jacky4566/JacksNixies/PCBV2/PCBV2T.png

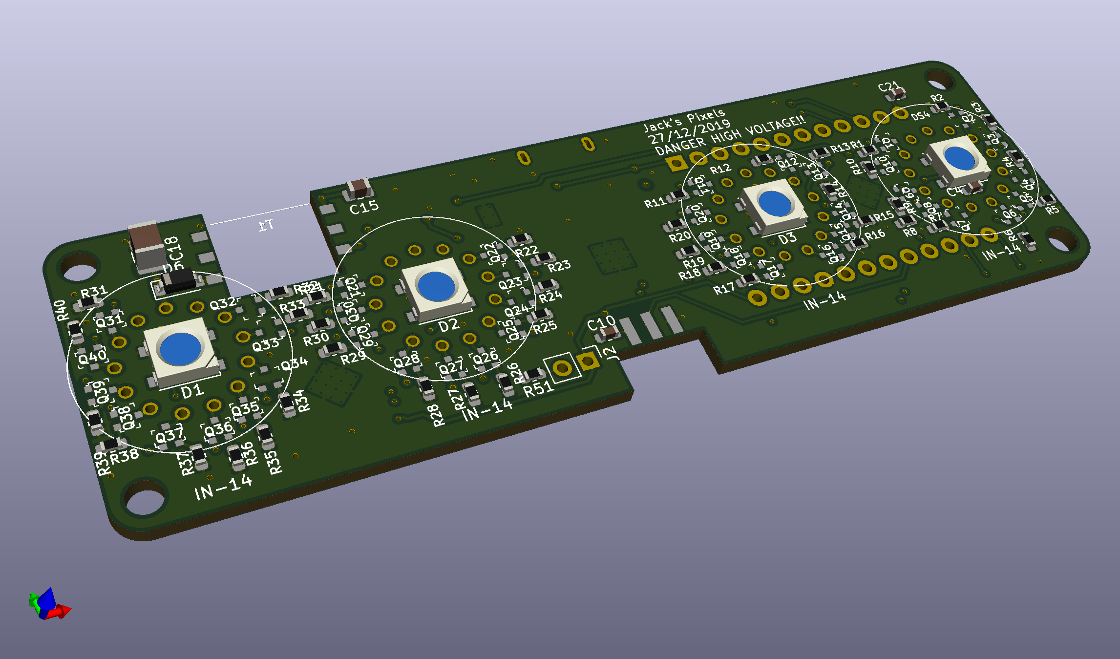
PCBV2/PCBV2T.png
