jacky4566/JacksNixies/PCBV2/PCBV2B.png

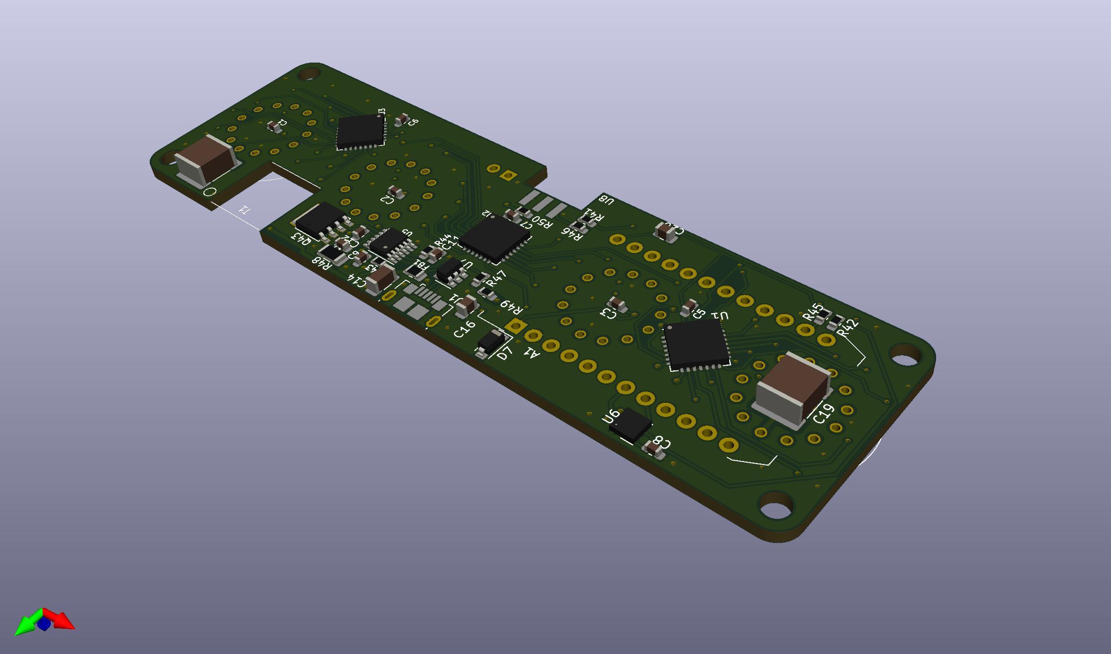
PCBV2/PCBV2B.png
