jacky4566/JacksNixies/Research/0x7d_nixietubeclock/README.md

# NixieTubeClock

Project files related to the Nixie Tube Clock project.

### Driver PCB
https://git.0x7d.com/Kevin/NixieTubeClock/raw/master/Nixie_Top_Board/PCB_Schematic.png











### Controller PCB
https://git.0x7d.com/Kevin/NixieTubeClock/raw/master/Nixie_Bottom_Board/PCB_Schematic.png

https://git.0x7d.com/Kevin/NixieTubeClock/raw/master/Nixie_Bottom_Board/PCB_Schematic2.png

https://git.0x7d.com/Kevin/NixieTubeClock/raw/master/Nixie_Bottom_Board/PCB_Full_NoSS.png







https://git.0x7d.com/Kevin/NixieTubeClock/raw/master/Nixie_Bottom_Board/PCB_Bottom.png
