jacky4566/JacksNixies/Research/0x7d_nixietubeclock/Misc Files/IN-24.jpg

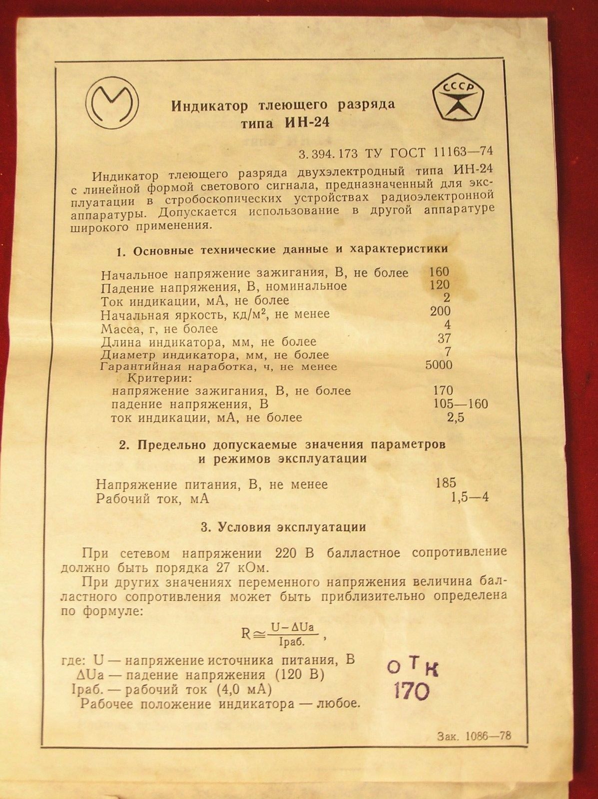
Research/0x7d_nixietubeclock/Misc Files/IN-24.jpg
