jacky4566/JacksNixies/Research/0x7d_nixietubeclock/Misc Files/TX4B-1.gif

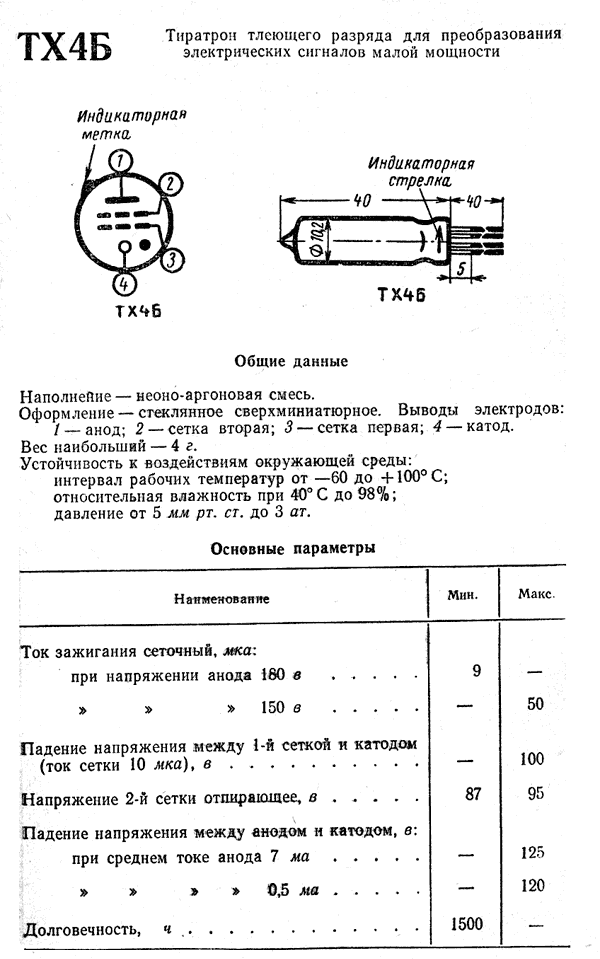
Research/0x7d_nixietubeclock/Misc Files/TX4B-1.gif
