jacky4566/JacksNixies/Research/0x7d_nixietubeclock/Misc Files/TX5B-2.jpg

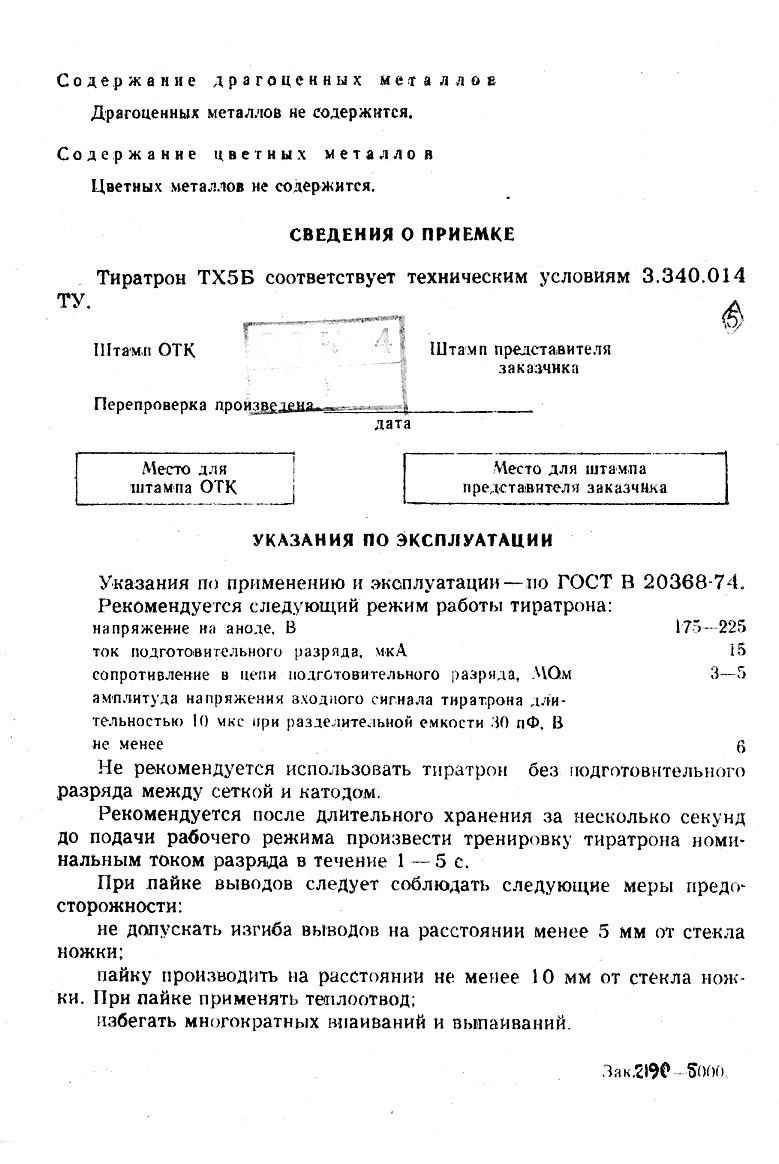
Research/0x7d_nixietubeclock/Misc Files/TX5B-2.jpg
