jacky4566/JacksNixies/Research/0x7d_nixietubeclock/Nixie_Bottom_Board/PCB_In2.png

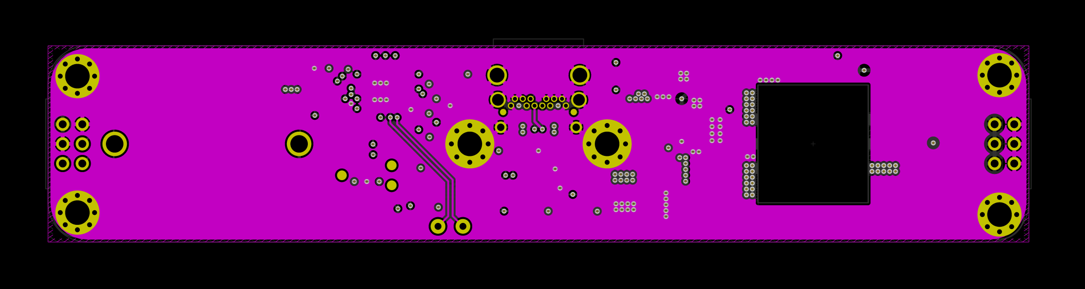
Research/0x7d_nixietubeclock/Nixie_Bottom_Board/PCB_In2.png
