jacky4566/JacksNixies/Research/0x7d_nixietubeclock/Nixie_Top_Board/PCB_Bottom.png

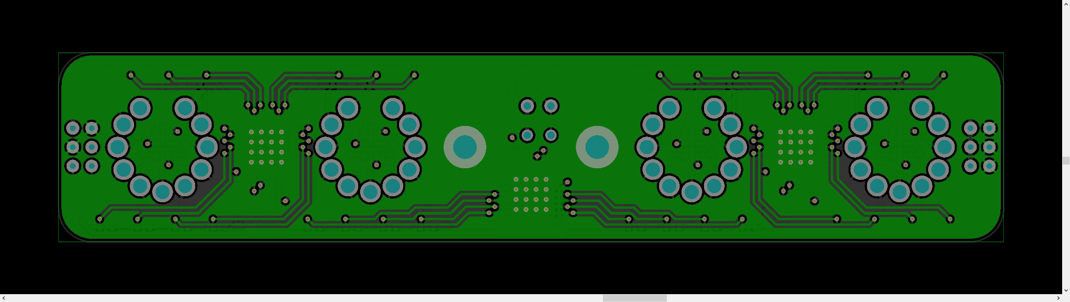
Research/0x7d_nixietubeclock/Nixie_Top_Board/PCB_Bottom.png
