jacky4566/JacksNixies/PCBV2/PCBV1_bom_.xlsx

Component | Description | Part | References | Value | Footprint | Quantity Per PCB | Digikey Part Num
1 | PHOTON WITH HEADERS | PHOTONH | A1 | PHOTONH | Particle_Photon | 1 | 1878-1005-ND
2 | Unpolarized capacitor, small symbol | C_Small | C1 C2 C3 C4 C5 C6 C7 C8 C10 C12 C13 C21 | 0.1uF | C_0603_1608Metric | 12 | 1276-1000-1-ND
3 | Unpolarized capacitor, small symbol | C_Small | C14 | 100uF | C_1206_3216Metric | 1 | 1276-1782-1-ND
4 | Unpolarized capacitor, small symbol | C_Small | C15 C16 C20 | 10uF | C_0805_2012Metric | 2 | 1276-2893-1-ND
5 | Unpolarized capacitor, small symbol | C_Small | C11 | 150nF | C_0603_1608Metric | 1 | 1276-1972-1-ND
6 | Unpolarized capacitor, small symbol | C_Small | C17 C18 C19 | 2.2uF | C_1210_3225Metric | 3 | 587-3380-1-ND
9 | Unpolarized capacitor, small symbol | C_Small | C9 | 560pF | C_0603_1608Metric | 1 | 490-1468-1-ND
10 | Bidirectional transient-voltage-suppression diode | D_TVS | D5 | 5.6V | D_SMA | 1 | SMAJ5.0ALFTR-ND
11 | Schottky diode | D_Schottky | D7, D6 | D_Schottky | D_SOD-123 | 2 | UF1GLWHRVGCT-ND
13 | 5050 RGBW LED 4-Pin with integrated IC | IN-PI55QATPRPGPBPW | D1 D2 D3 D4 | IN-PI55QATPRPGPBPW | LED_Inolux_IN-PI554FCH_PLCC4_5.0x5.0mm_P3.2mm | 4 | 1830-1210-2-ND
14 |  | NIXIE_IN14 | DS1 DS2 DS3 DS4 | NIXIE_IN14 | Nixie_IN_14 | 4
15 | Ferrite bead, small symbol | Ferrite_Bead_Small | FB1 | Ferrite_Bead_Small | R_0805_2012Metric | 1 | 732-1620-1-ND
16 | Generic connector, single row, 01x02, script generated (kicad-library-utils/schlib/autogen/connector/) | Conn_01x02_Female | J2 | Conn_01x02_Female | PinHeader_1x02_P2.54mm_Vertical | 1 | 475-1077-ND
17 | USB Micro Type B connector | USB_B_Micro | J1 | USB_B_Micro | USB_Micro-B_GCT_USB3076-30-A | 1 | 2073-USB3076-30-ACT-ND
18 | 100A, 60V Vds, N-Channel MOSFET, 5.2mOhm Ron, LFPAK56 | PSMN5R2-60YL | Q43 | PSMN5R2-60YL | LFPAK56 | 1 | 1727-2595-1-ND
19 | NPN transistor, base/emitter/collector | Q_NPN_BEC | Q1 Q2 Q3 Q4 Q5 Q6 Q7 Q8 Q9 Q10 Q11 Q12 Q13 Q14 Q15 Q16 Q17 Q18 Q19 Q20 Q21 Q22 Q23 Q24 Q25 Q26 Q27 Q28 Q29 Q30 Q31 Q32 Q33 Q34 Q35 Q36 Q37 Q38 Q39 Q40 | Q_NPN_BEC | SOT-323 | 40 | MSD42WT1GOSCT-ND
20 | Resistor, small symbol | R_Small | R49 | 1.6M | R_0603_1608Metric | 1 | P1.60MHCT-ND
21 | Resistor, small symbol | R_Small | R48 | 10m | R_1206_3216Metric | 1 | ERJ-8CWFR010V
22 | Resistor, small symbol | R_Small | R47 | 13k | R_0603_1608Metric | 1 | P13.0KHCT-ND
23 | Resistor, small symbol | R_Small | R41 R50 | 1M | R_0603_1608Metric | 2 | P1.00MHCT-ND
24 | Resistor, small symbol | R_Small | R1 R2 R3 R4 R5 R6 R7 R8 R9 R10 R11 R12 R13 R14 R15 R16 R17 R18 R19 R20 R21 R22 R23 R24 R25 R26 R27 R28 R29 R30 R31 R32 R33 R34 R35 R36 R37 R38 R39 R40 | 1k | R_0603_1608Metric | 40 | P1.00KHCT-ND
25 | Resistor, small symbol | R_Small | R43 | 300k | R_0603_1608Metric | 1 | P300KHCT-ND
26 | Resistor, small symbol | R_Small | R42 R45 R51 | 4.7k | R_0603_1608Metric | 3 | P4.70KHCT-ND
27 | Resistor, small symbol | R_Small | R44 R46 | 86.6K | R_0603_1608Metric | 2 | P86.6KHCT-ND
28 |  | 750312367 | T1 | 750312367 | 750312367 | 1 | 1297-1017-1-ND
29 |  | AM612-MargoGeneral | U8 | AM612 | AM612_Horz | 1
30 | It is a digital 4 in 1 sensor with gas, humidity, pressure and temperature measurements, LGA-8 | BME680 | U6 | BME680 | Bosch_LGA-8_3x3mm_P0.8mm_ClockwisePinNumbering | 1 | 828-1077-1-ND
31 |  | LT3759 | U5 | LT3759 | MSOP-12-1EP_3x4mm_P0.65mm_EP1.65x2.85mm_ThermalVias | 1 | LT3759EMSE#TRPBFCT-ND
32 | 16-channel 12-bit PWM Fm+ I2C-bus LED controller RGBA QFN | PCA9685BS | U1 U2 U3 | PCA9685BS | QFN-28-1EP_6x6mm_P0.65mm_EP4.25x4.25mm_ThermalVias | 3 | 568-5305-1-ND
33 | Single-Bit Dual-Supply Bus Transceiver With Configurable Voltage Translation and 3-State Outputs, SOT-563 | SN74LVC1T45DRL | U4 | SN74LVC1T45DRL | SOT-563 | 1 | 296-20629-1-ND
34 | USB Dedicated Charging Port Controller | TPS2514 | U7 | TPS2514 | SOT-23-6 | 1 | 296-40725-1-ND
