jacky4566/JacksNixies/PCBV1/Main/Assem16.SLDASM

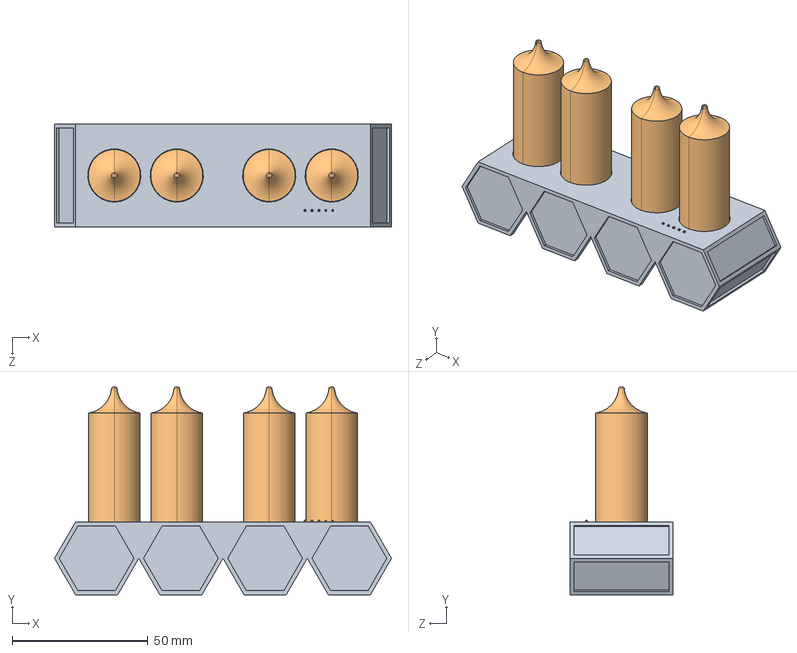
[picture p22: CAD file, 2020-06-26]
PCBV1/Main/Assem16.SLDASM
124.0 x 76.4 x 38.0 mm
Case1
PCBV1
