jacky4566/JacksNixies/Housing 1.SLDPRT

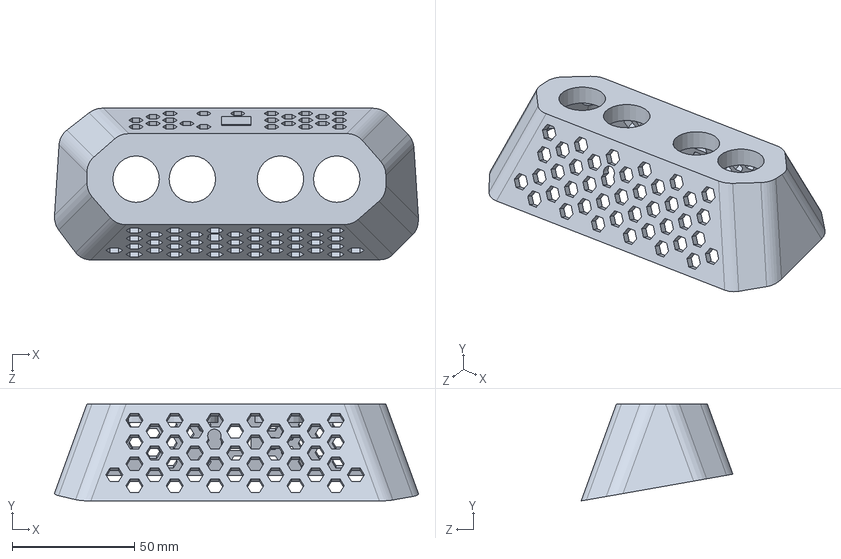
[picture p23: CAD file, 2020-06-26]
Housing 1.SLDPRT
148.8 x 39.6 x 62.0 mm
