jacky4566/JacksNixies/PCBV1/Main/PCBV1.SLDPRT

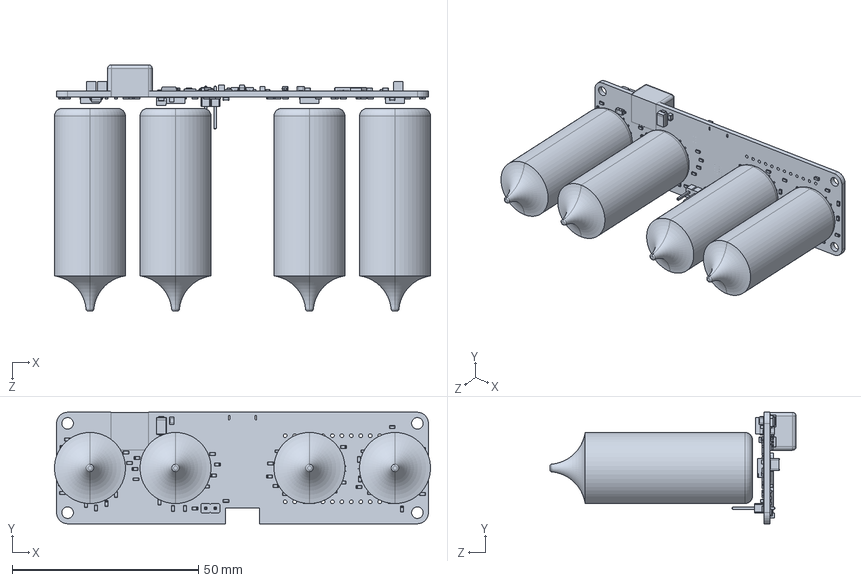
[picture p24: CAD file, 2020-06-26]
PCBV1/Main/PCBV1.SLDPRT
101.1 x 30.0 x 66.2 mm
