jacky4566/JacksNixies/Lid.SLDPRT

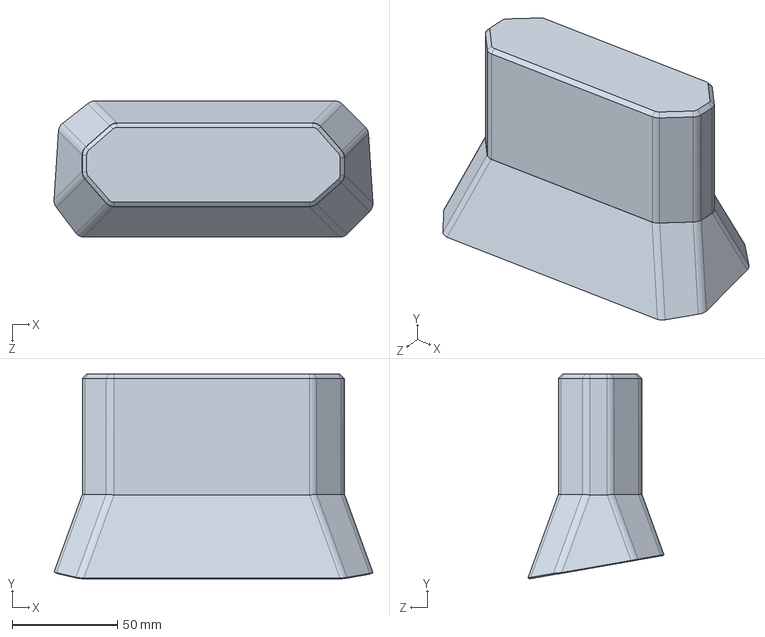
[picture p25: CAD file, 2020-06-26]
Lid.SLDPRT
151.9 x 97.5 x 64.9 mm
