jacky4566/JacksNixies/PCBV1/Main/Case1.SLDPRT

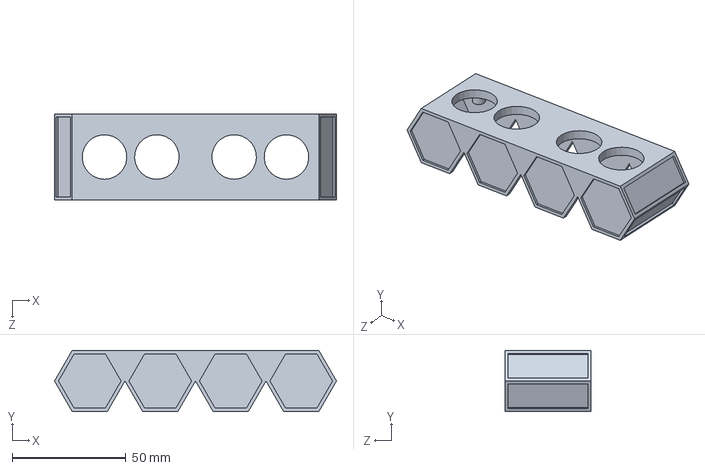
[picture p26: CAD file, 2020-06-26]
PCBV1/Main/Case1.SLDPRT
124.0 x 26.8 x 38.0 mm
