jacky4566/JacksNixies/Alignment Tool.SLDPRT

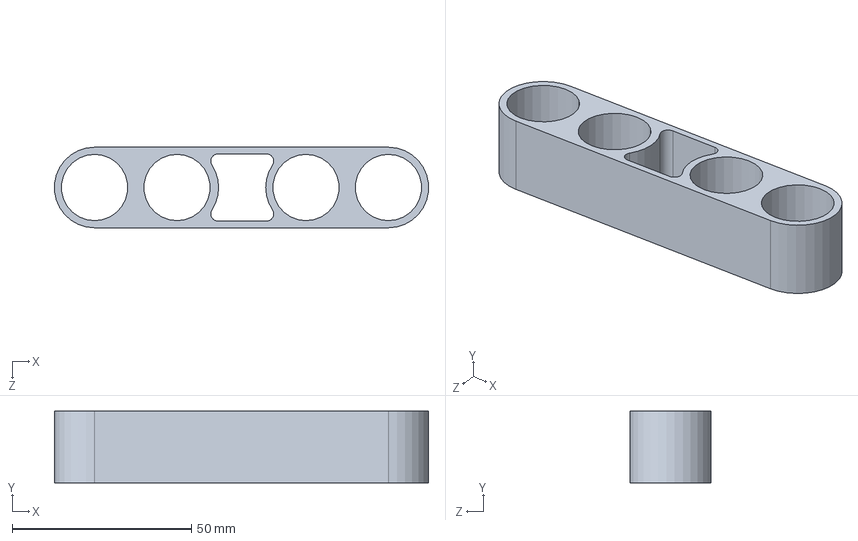
[picture p27: CAD file, 2020-06-26]
Alignment Tool.SLDPRT
104.4 x 20.0 x 22.5 mm
