jacky4566/JacksNixies/(list of files, cad)

Other CAD files:
Alignment Tool.STL
Housing 1.STL
Lid.STL
PCBV1/Main/Case1.STL
