jacky4566/JacksNixies/Research/0x7d_nixietubeclock/Nixie_PSU_Breakout/Efficiency Measurement.xlsx

Sheet: 8200HV
Input Voltage | Input Current | Output Voltage | Output Current | Input Power | Output Power | % Efficiency
3 | 0.079 | 171.4 | 0.001 | 0.237 | 0.171 | 0.723
3 | 0.145 | 170.6 | 0.002 | 0.435 | 0.341 | 0.784
3 | 0.202 | 170.7 | 0.003 | 0.606 | 0.512 | 0.845
3 | 0.270 | 170.4 | 0.004 | 0.810 | 0.682 | 0.841
3 | 0.337 | 170.3 | 0.005 | 1.011 | 0.852 | 0.842
3 | 0.405 | 170.2 | 0.006 | 1.215 | 1.021 | 0.840
3 | 0.471 | 170.0 | 0.007 | 1.413 | 1.190 | 0.842
3 | 0.537 | 169.9 | 0.008 | 1.611 | 1.359 | 0.844
3 | 0.605 | 169.9 | 0.009 | 1.815 | 1.529 | 0.842
3 | 0.676 | 169.8 | 0.010 | 2.028 | 1.698 | 0.837
3 | 0.747 | 169.6 | 0.011 | 2.241 | 1.866 | 0.832
3 | 0.829 | 169.5 | 0.012 | 2.487 | 2.034 | 0.818
3 | 0.897 | 169.5 | 0.013 | 2.691 | 2.204 | 0.819
3 | 0.968 | 169.4 | 0.014 | 2.904 | 2.372 | 0.817
5 | 0.045 | 171.6 | 0.001 | 0.225 | 0.172 | 0.763
5 | 0.088 | 171.5 | 0.002 | 0.440 | 0.343 | 0.780
5 | 0.122 | 171.1 | 0.003 | 0.610 | 0.513 | 0.841
5 | 0.160 | 170.9 | 0.004 | 0.800 | 0.684 | 0.854
5 | 0.201 | 170.8 | 0.005 | 1.005 | 0.854 | 0.850
5 | 0.240 | 170.7 | 0.006 | 1.200 | 1.024 | 0.854
5 | 0.276 | 170.7 | 0.007 | 1.380 | 1.195 | 0.866
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
