jacky4566/JacksNixies/PCBV2/PCBV2_Schematic.pdf

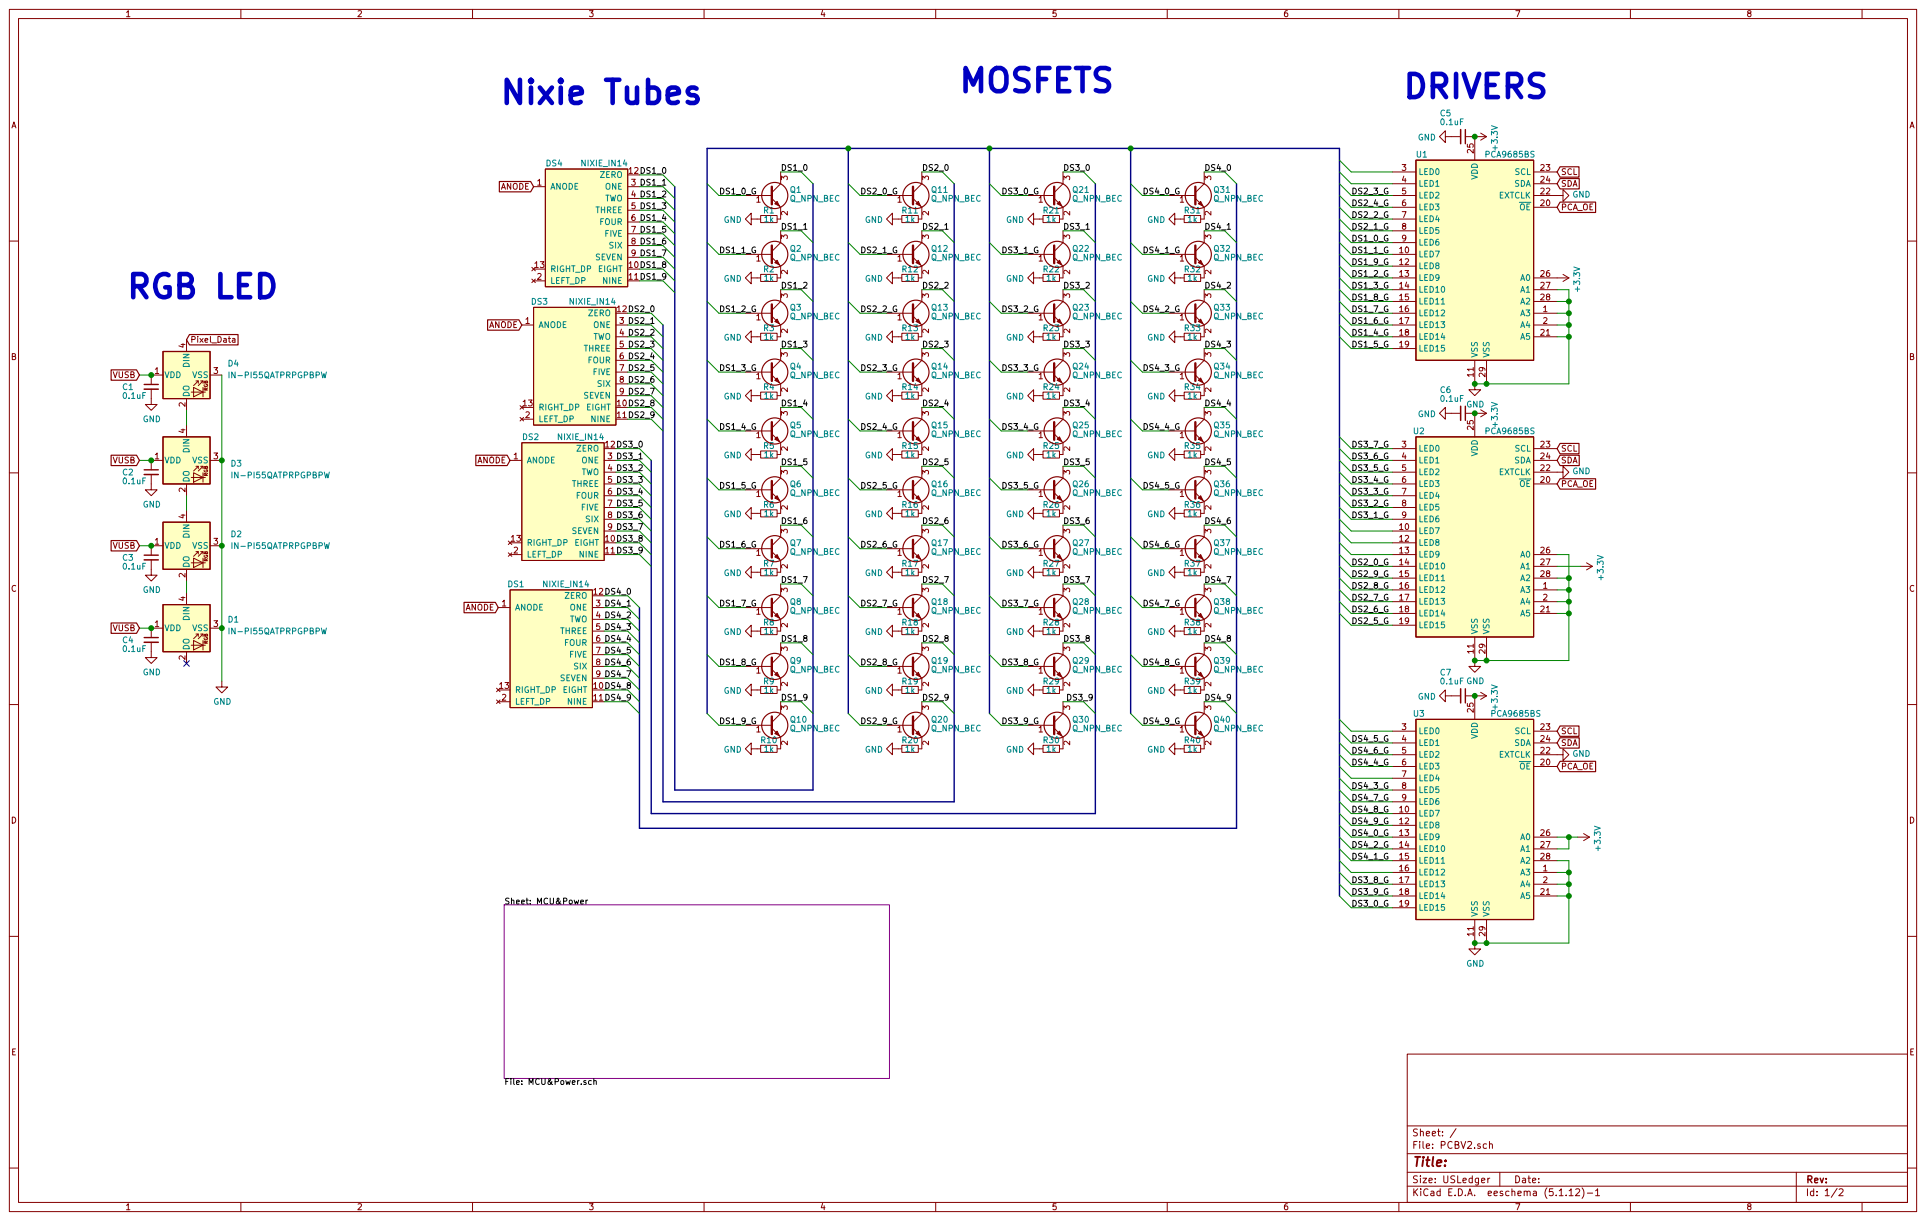
[picture p28: page 1]

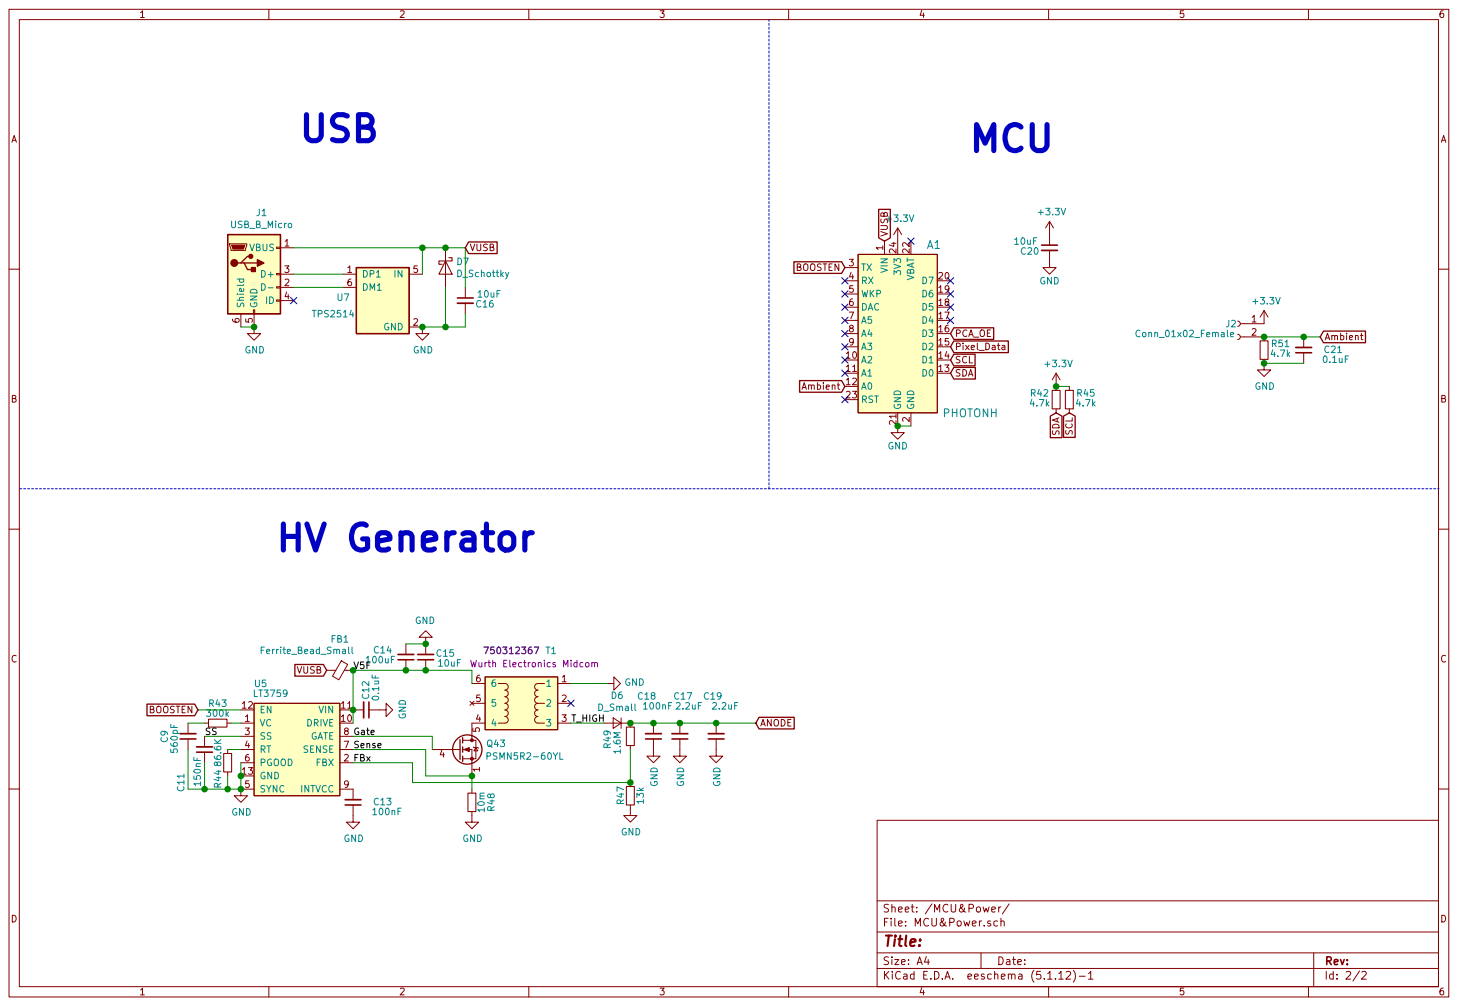
[picture p29: page 2]

2 TX 3 RX 4 WKP 5 DAC 6 A5 7 A4 8 A3 9 A2 10 D7 20 A1 11 GND 21 A0 12 VBAT 22 D0 13 RST 23 D1 14 3V3 24 D2 15 D3 16 D4 17 D5 18 D6 19 A1 PHOTONH
