jacky4566/JacksNixies/PCBV1/Main/Print Schematic.pdf

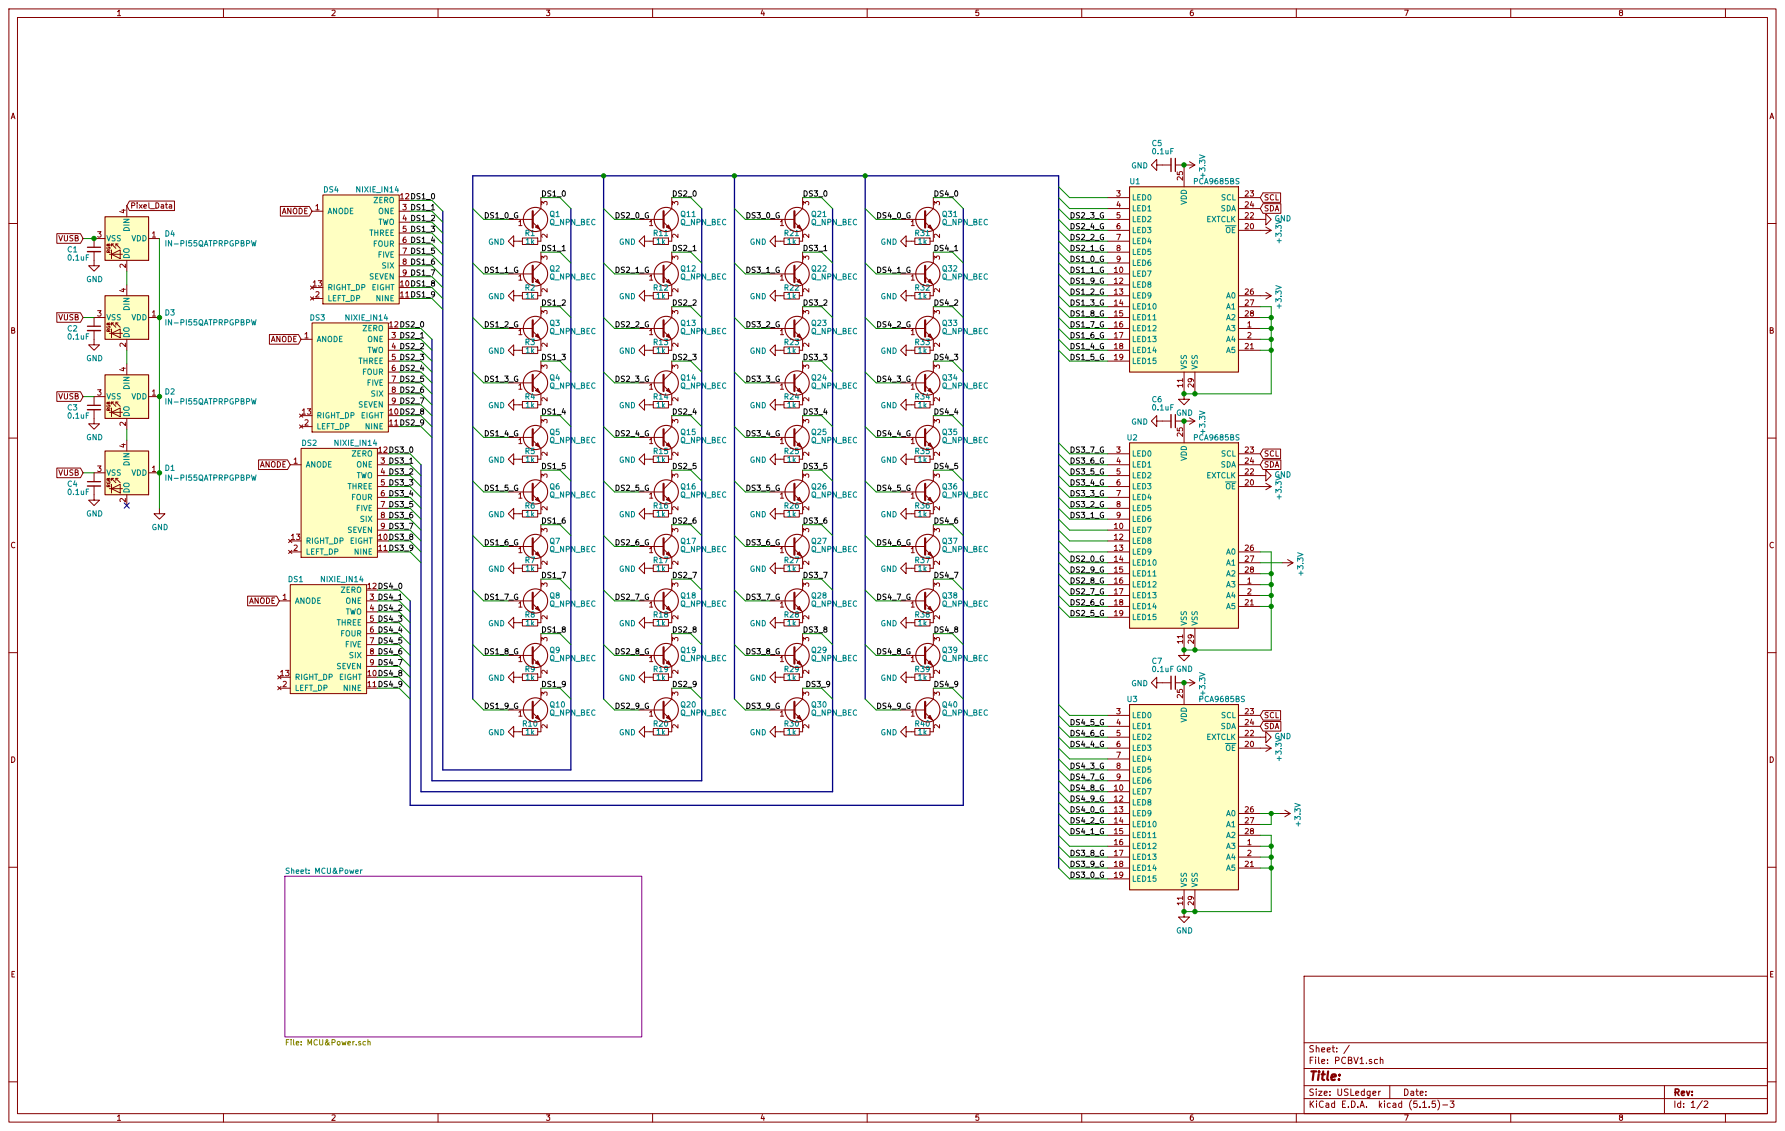
[picture p30: page 1]

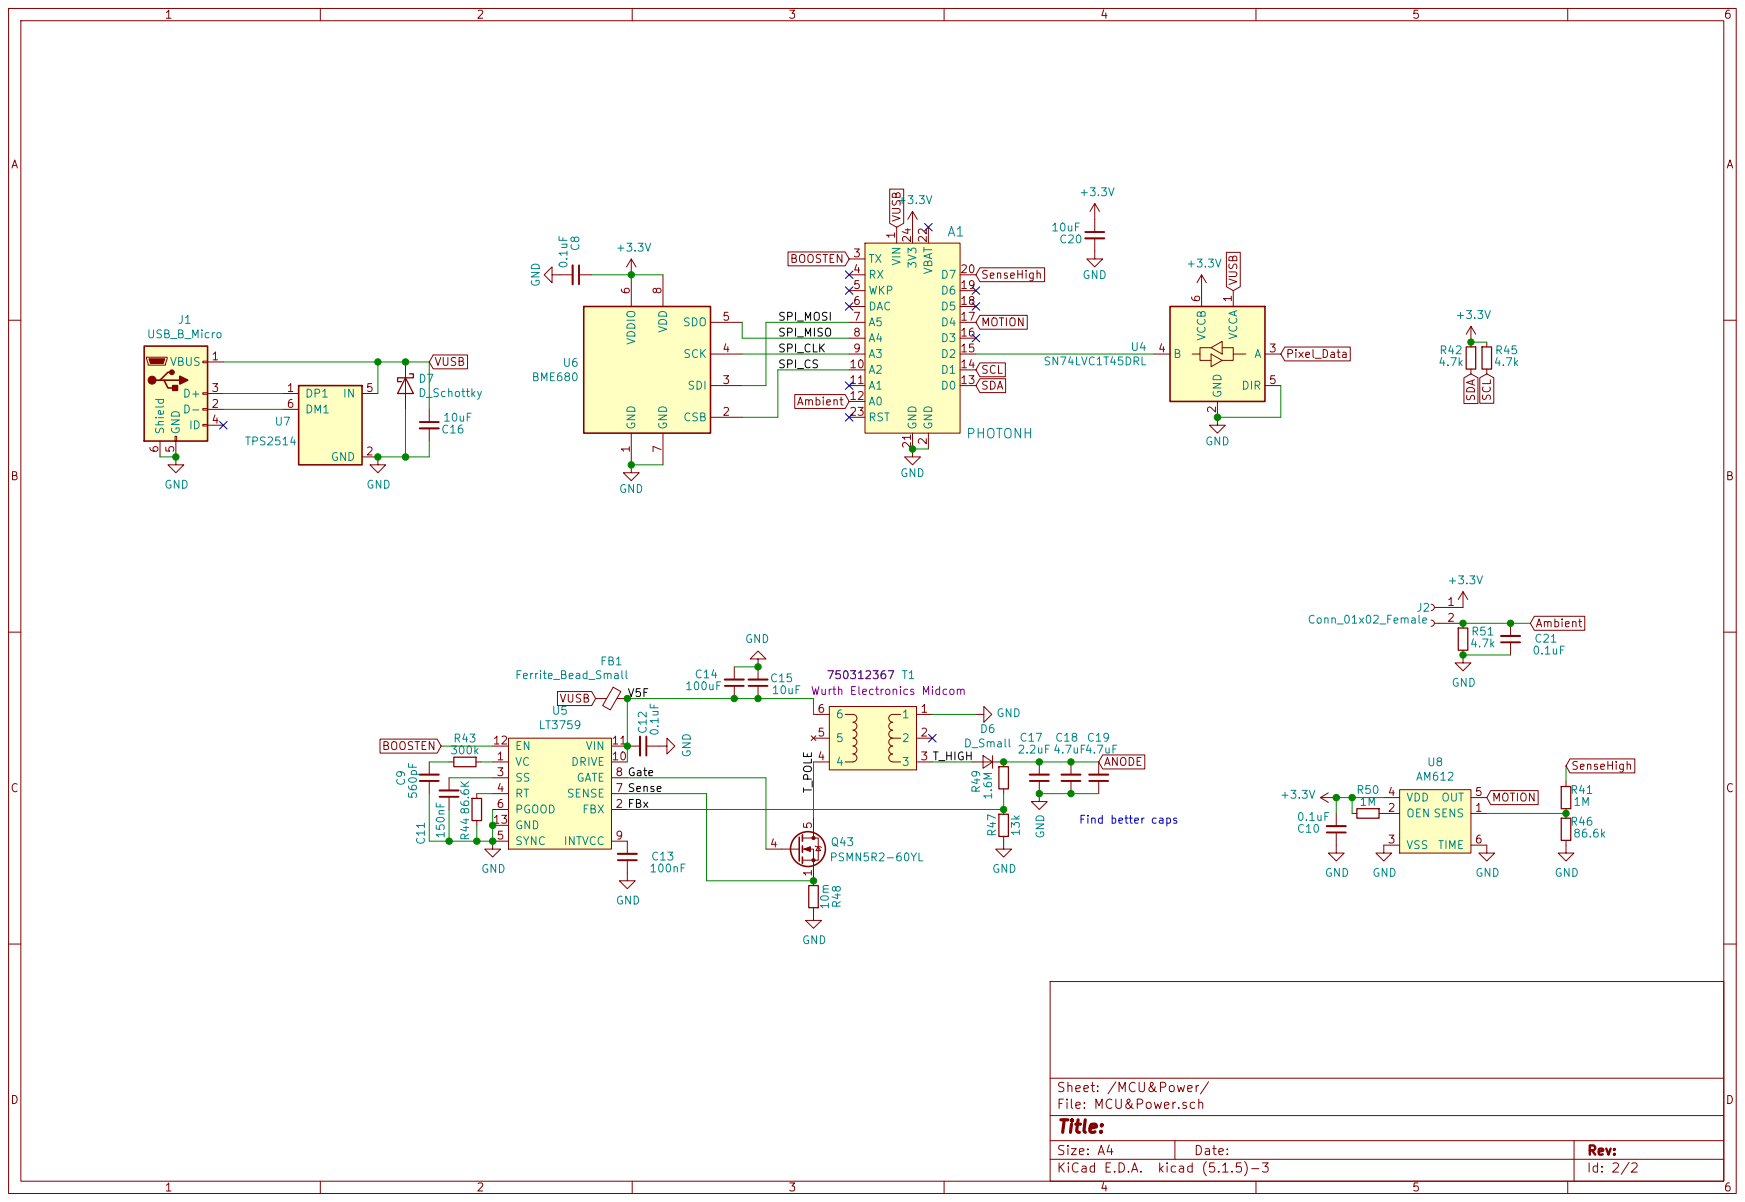
[picture p31: page 2]
