jacky4566/JacksNixies/Research/0x7d_nixietubeclock/Nixie_PSU_Breakout/LTspice/Schematic.asc

C1: cap; 1.2µ; V=200 Irms=4.41 Rser=0.0220943 Lser=0 mfg="KEMET" pn="C1825C125K2RAC" type="X7R"
C2: cap; 1µ; V=200 Irms=3.96 Rser=0.0234673 Lser=0 mfg="KEMET" pn="C1825C105K2RAC" type="X7R"
C3: cap; 0.1µ; V=25 Irms=2.1 Rser=0.0606238 Lser=0 mfg="KEMET" pn="C1210C104K3RAC" type="X7R"
C4: cap; 100µ; V=25 Irms=18.5 Rser=0.00262245 Lser=0
C5: cap; 150n; V=50 Irms=1.11 Rser=0.0283161 Lser=0
C6: cap; 500p; V=16 Irms=647m Rser=0.0322889 Lser=0
C7: cap; 4.7µ; V=50 Irms=0 Rser=0.004 Lser=0 mfg="TDK" pn="C575OX7RIH475M" type="X7R"
D1: diode; RFU02VS6S
I1: load2; PULSE(0 -0.002 16m)
R1: res; 10m; tol=1 pwr=0.1
R2: res; 86.6K; tol=1 pwr=0.1
R3: res; 300k; tol=1 pwr=0.1
R4: res; 1.6Meg; tol=1 pwr=0.1
R5: res; 13k; tol=1 pwr=0.1
U1: LT3759
U2: 750312367
U3: EPCGaN; EPC2016
V1: voltage; 3.7; Rser=20m
Named nets: VOUT, 0, VIN
.tran 0 40m 1m
