jacky4566/JacksNixies/Research/0x7d_nixietubeclock/Nixie_Top_Board/nixie_top_board.kicad_pcb

## KiCad design Research/0x7d_nixietubeclock/Nixie_Top_Board/nixie_top_board.kicad_pcb (2020-06-26)

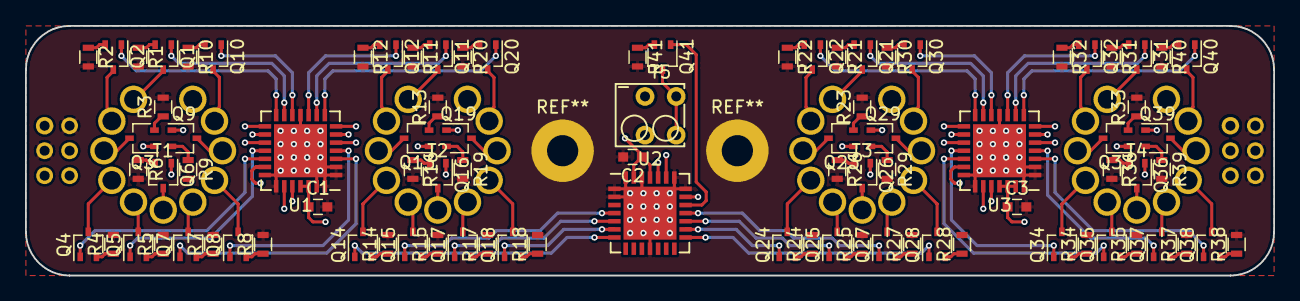
[picture p32: board nixie_top_board.kicad_pcb from above]

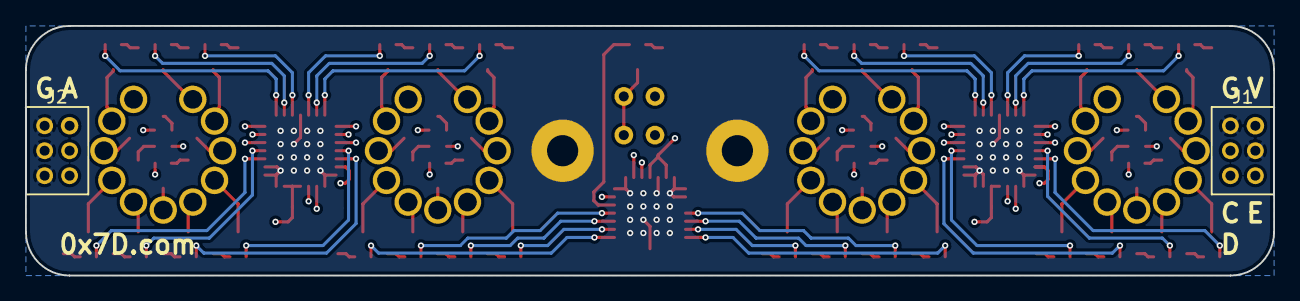
[picture p33: board nixie_top_board.kicad_pcb from below]

Board: 4 copper layers, 100.0 x 20.0 mm, 95 parts (2 on the bottom side), 129 nets.

Parts:
C1, C2, C3: Bypass; C_0603
J1, J2: Conn_02x03_Odd_Even; Pin_Header_Straight_2x03_Pitch2.00mm
Q1, Q2, Q3, Q4, Q5, Q6, Q7, Q8, Q9, Q10, Q11, Q12, Q13, Q14, Q15, Q16, Q17, Q18, Q19, Q20, Q21, Q22, Q23, Q24, Q25, Q26, Q27, Q28, Q29, Q30, Q31, Q32, Q33, Q34, Q35, Q36, Q37, Q38, Q39, Q40, Q41: Q_NPN_BEC; SOT-323_SC-70
R1, R2, R3, R4, R5, R6, R7, R8, R9, R10, R11, R12, R13, R14, R15, R16, R17, R18, R19, R20, R21, R22, R23, R24, R25, R26, R27, R28, R29, R30, R31, R32, R33, R34, R35, R36, R37, R38, R39, R40, R41: R; R_0603
T1, T2, T3, T4: IN-8
T5: IN-3; Phoenix_1770953
U1, U2, U3: PCA9685; QFN-28-1EP_6x6mm_Pitch0.65mm

Connections:
/ANODE: J2.1, J2.3, J2.5, T1.11, T2.11, T3.11, T4.11, T5.1
/GND: C1.2, C2.2, C3.2, J1.2, J1.3, J2.2, J2.4, J2.6, R1.2, R2.2, R3.2, R4.2, R5.2, R6.2, R7.2, R8.2, R9.2, R10.2, R11.2, R12.2, R13.2, R14.2, R15.2, R16.2, R17.2, R18.2, R19.2, R20.2, R21.2, R22.2, R23.2, R24.2, R25.2, R26.2, R27.2, R28.2, R29.2, R30.2, R31.2, R32.2, R33.2, R34.2, R35.2, R36.2, R37.2, R38.2, R39.2, R40.2, R41.2, U1.1, U1.2, U1.11, U1.21, U1.22, U1.27, U1.28, U1.29, U2.1, U2.2, U2.11, U2.21, U2.22, U2.26, U2.28, U2.29, U3.1, U3.2, U3.11, U3.21, U3.22, U3.28, U3.29
/SCL: J1.4, U1.23, U2.23, U3.23
/SDA: J1.6, U1.24, U2.24, U3.24
/T1_C_0: Q1.3, T1.1
/T1_C_1: Q2.3, T1.2
/T1_C_2: Q3.3, T1.3
/T1_C_3: Q4.3, T1.4
/T1_C_4: Q5.3, T1.5
/T1_C_5: Q6.3, T1.6
/T1_C_6: Q7.3, T1.7
/T1_C_7: Q8.3, T1.8
/T1_C_8: Q9.3, T1.9
/T1_C_9: Q10.3, T1.10
/T1_E_0: Q1.2, R1.1
/T1_E_1: Q2.2, R2.1
/T1_E_2: Q3.2, R3.1
/T1_E_3: Q4.2, R4.1
/T1_E_4: Q5.2, R5.1
/T1_E_5: Q6.2, R6.1
/T1_E_6: Q7.2, R7.1
/T1_E_7: Q8.2, R8.1
/T1_E_8: Q9.2, R9.1
/T1_E_9: Q10.2, R10.1
/T1_G_0: Q1.1, U1.13
/T1_G_1: Q2.1, U1.14
/T1_G_2: Q3.1, U1.16
/T1_G_3: Q4.1, U1.19
/T1_G_4: Q5.1, U1.18
/T1_G_5: Q6.1, U1.15
/T1_G_6: Q7.1, U1.3
/T1_G_7: Q8.1, U1.4
/T1_G_8: Q9.1, U1.17
/T1_G_9: Q10.1, U1.12
/T2_C_0: Q11.3, T2.1
/T2_C_1: Q12.3, T2.2
/T2_C_2: Q13.3, T2.3
/T2_C_3: Q14.3, T2.4
/T2_C_4: Q15.3, T2.5
/T2_C_5: Q16.3, T2.6
/T2_C_6: Q17.3, T2.7
/T2_C_7: Q18.3, T2.8
/T2_C_8: Q19.3, T2.9
/T2_C_9: Q20.3, T2.10
/T2_E_0: Q11.2, R11.1
/T2_E_1: Q12.2, R12.1
/T2_E_2: Q13.2, R13.1
/T2_E_3: Q14.2, R14.1
/T2_E_4: Q15.2, R15.1
/T2_E_5: Q16.2, R16.1
/T2_E_6: Q17.2, R17.1
/T2_E_7: Q18.2, R18.1
/T2_E_8: Q19.2, R19.1
/T2_E_9: Q20.2, R20.1
/T2_G_0: Q11.1, U1.9
/T2_G_1: Q12.1, U1.10
/T2_G_2: Q13.1, U1.5
/T2_G_3: Q14.1, U2.7
/T2_G_4: Q15.1, U2.4
/T2_G_5: Q16.1, U1.7
/T2_G_6: Q17.1, U2.5
/T2_G_7: Q18.1, U2.6
/T2_G_8: Q19.1, U1.6
/T2_G_9: Q20.1, U1.8
/T3_C_0: Q21.3, T3.1
/T3_C_1: Q22.3, T3.2
/T3_C_2: Q23.3, T3.3
/T3_C_3: Q24.3, T3.4
/T3_C_4: Q25.3, T3.5
/T3_C_5: Q26.3, T3.6
/T3_C_6: Q27.3, T3.7
/T3_C_7: Q28.3, T3.8
/T3_C_8: Q29.3, T3.9
/T3_C_9: Q30.3, T3.10
/T3_E_0: Q21.2, R21.1
/T3_E_1: Q22.2, R22.1
/T3_E_2: Q23.2, R23.1
/T3_E_3: Q24.2, R24.1
/T3_E_4: Q25.2, R25.1
/T3_E_5: Q26.2, R26.1
/T3_E_6: Q27.2, R27.1
/T3_E_7: Q28.2, R28.1
/T3_E_8: Q29.2, R29.1
/T3_E_9: Q30.2, R30.1
/T3_G_0: Q21.1, U3.13
/T3_G_1: Q22.1, U3.14
/T3_G_2: Q23.1, U3.16
/T3_G_3: Q24.1, U2.16
/T3_G_4: Q25.1, U2.17
/T3_G_5: Q26.1, U3.15
/T3_G_6: Q27.1, U2.18
/T3_G_7: Q28.1, U2.15
/T3_G_8: Q29.1, U3.17
/T3_G_9: Q30.1, U3.12
/T4_C_0: Q31.3, T4.1
/T4_C_1: Q32.3, T4.2
/T4_C_2: Q33.3, T4.3
/T4_C_3: Q34.3, T4.4
/T4_C_4: Q35.3, T4.5
/T4_C_5: Q36.3, T4.6
/T4_C_6: Q37.3, T4.7
/T4_C_7: Q38.3, T4.8
/T4_C_8: Q39.3, T4.9
/T4_C_9: Q40.3, T4.10
/T4_E_0: Q31.2, R31.1
/T4_E_1: Q32.2, R32.1
/T4_E_2: Q33.2, R33.1
/T4_E_3: Q34.2, R34.1
/T4_E_4: Q35.2, R35.1
/T4_E_5: Q36.2, R36.1
/T4_E_6: Q37.2, R37.1
/T4_E_7: Q38.2, R38.1
/T4_E_8: Q39.2, R39.1
/T4_E_9: Q40.2, R40.1
/T4_G_0: Q31.1, U3.9
/T4_G_1: Q32.1, U3.10
/T4_G_2: Q33.1, U3.5
/T4_G_3: Q34.1, U3.18
/T4_G_4: Q35.1, U3.19
/T4_G_5: Q36.1, U3.7
/T4_G_6: Q37.1, U3.4
/T4_G_7: Q38.1, U3.3
/T4_G_8: Q39.1, U3.6
/T4_G_9: Q40.1, U3.8
/VDD: C1.1, C2.1, C3.1, J1.1, U1.25, U1.26, U2.25, U2.27, U3.25, U3.26, U3.27
/nOE: J1.5, U1.20, U2.20, U3.20
unnamed: Q41.1, U2.19
unnamed: Q41.2, R41.1
unnamed: Q41.3, T5.2
