jacky4566/JacksNixies/Research/0x7d_nixietubeclock/Nixie_Bottom_Board/nixie_bottom_board.kicad_pcb

## KiCad design Research/0x7d_nixietubeclock/Nixie_Bottom_Board/nixie_bottom_board.kicad_pcb (2020-06-26)

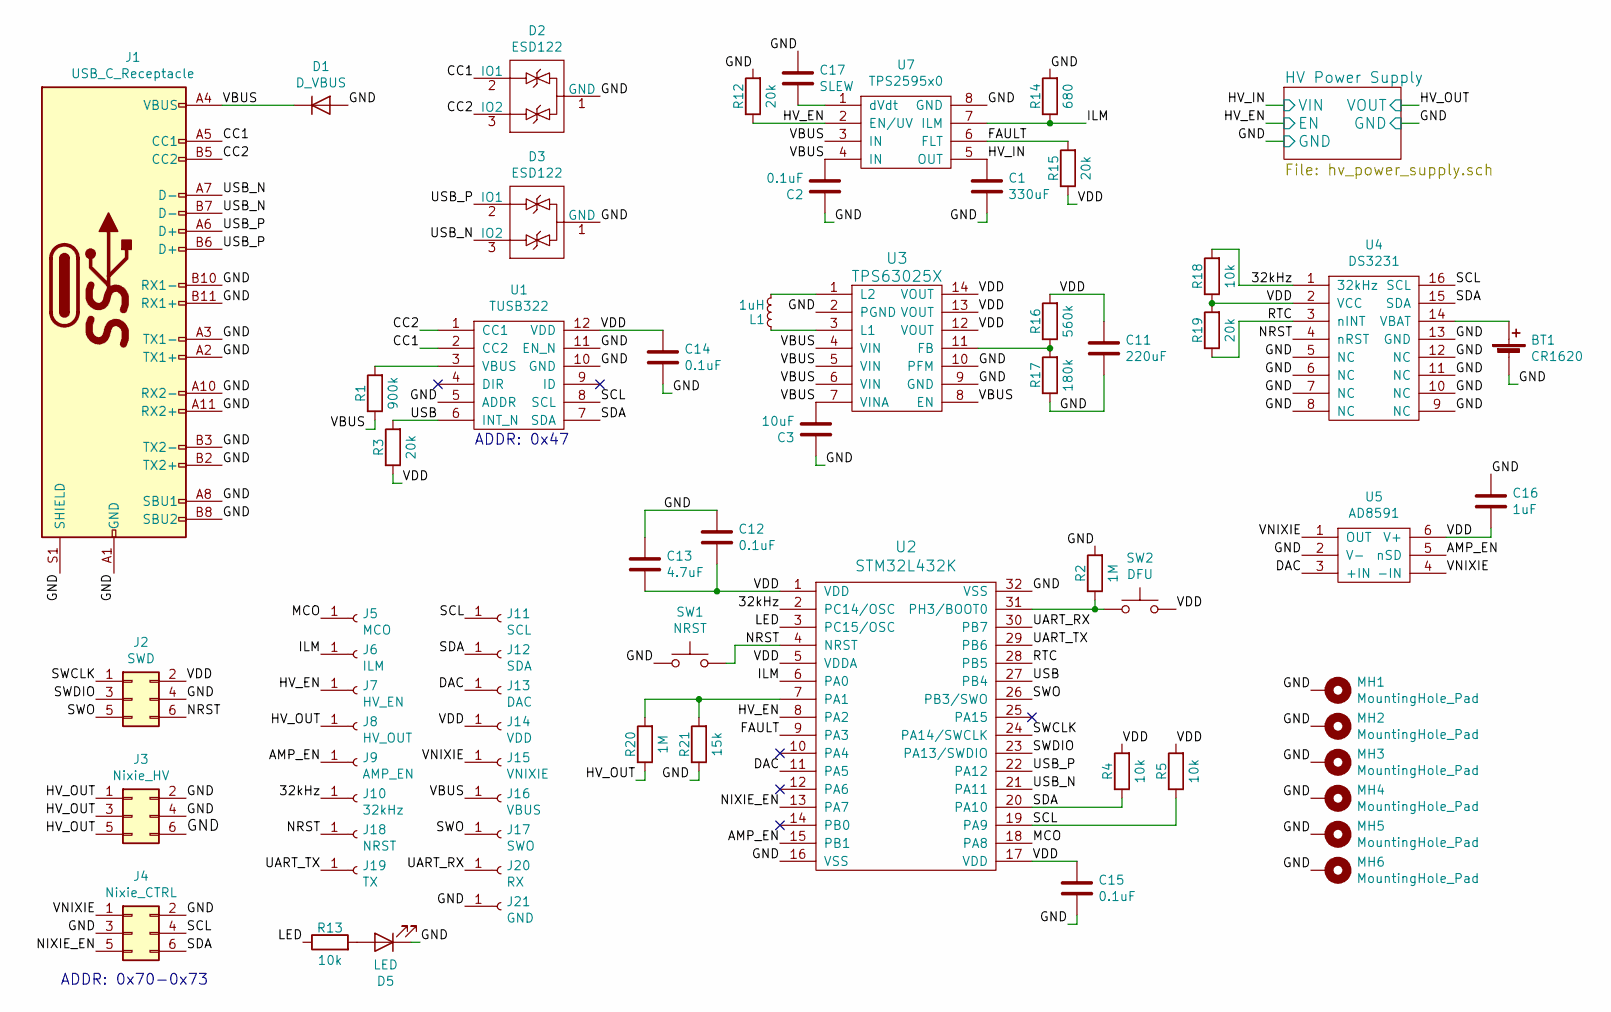
[picture p34: schematic nixie_bottom_board.sch, Bottom PCB]

Parts:
BT1: CR1620; CR1620_Holder_TH
C1: 330uF; CP_Tantalum_Case-X_EIA-7343-43_Reflow
C2, C12, C14, C15: 0.1uF; C_0603
C3: 10uF; C_0603
C11: 220uF; C_1210
C13: 4.7uF; C_0603
C16: 1uF; C_0603
C17: SLEW; C_0603
D1: D_VBUS; X1SON
D2, D3: ESD122; DMX0003A
D5: LED; LED_0603
J1: USB_C_Receptacle; USB_C_Receptacle_Circular_Holes
J2: SWD; TC2030-MCP-NL
J3: Nixie_HV; Pin_Header_Harwin_2x03_Pitch2.00mm
J4: Nixie_CTRL; Pin_Header_Harwin_2x03_Pitch2.00mm
J5: MCO; TestPoint_Pad_D1.5mm
J6: ILM; TestPoint_Pad_D1.5mm
J7: HV_EN; TestPoint_Pad_D1.5mm
J8: HV_OUT; TestPoint_Pad_D1.5mm
J9: AMP_EN; TestPoint_Pad_D1.5mm
J10: 32kHz; TestPoint_Pad_D1.5mm
J11: SCL; TestPoint_Pad_D1.5mm
J12: SDA; TestPoint_Pad_D1.5mm
J13: DAC; TestPoint_Pad_D1.5mm
J14: VDD; TestPoint_Pad_D1.5mm
J15: VNIXIE; TestPoint_Pad_D1.5mm
J16: VBUS; TestPoint_Pad_D1.5mm
J17: SWO; TestPoint_Pad_D1.5mm
J18: NRST; TestPoint_Pad_D1.5mm
J19: TX; TestPoint_THTPad_D1.5mm_Drill0.7mm
J20: RX; TestPoint_THTPad_D1.5mm_Drill0.7mm
J21: GND; TestPoint_Pad_D1.5mm
L1: 1uH; Inductor_4.1x4.1mm
MH1, MH2, MH3, MH4, MH5, MH6: MountingHole_Pad; MountingHole_2.5mm_Pad_Via
R1: 900k; R_0603
R2, R20: 1M; R_0603
R3, R12, R15, R19: 20k; R_0603
R4, R5, R13, R18: 10k; R_0603
R14: 680; R_0603
R16: 560k; R_0603
R17: 180k; R_0603
R21: 15k; R_0603
SW1: NRST; EVQP2
SW2: DFU; EVQP2
U1: TUSB322; X2QFN-12_1.6x1.6mm_Pitch0.4mm
U2: STM32L432K; QFN-32-1EP_5x5mm_Pitch0.5mm
U3: TPS63025X; VQFN-14_2.5x3mm_Pitch0.5mm
U4: DS3231; SOIC-16W_7.5x10.3mm_Pitch1.27mm
U5: AD8591; SOT-23-6
U7: TPS2595x0; WSON-8_1EP_2x2mm_Pitch0.5mm

Connections:
/32kHz: J10.1, R18.2, U2.2 (PC14/OSC), U4.1 (32kHz)
/AMP_EN: J9.1, U2.15 (PB1), U5.5 (nSD)
/CC1: D2.2 (IO1), J1.A5 (CC1), U1.2 (CC2)
/CC2: D2.3 (IO2), J1.B5 (CC2), U1.1 (CC1)
/DAC: J13.1, U2.11 (PA5), U5.3 (+IN)
/FAULT: R15.2, U2.9 (PA3), U7.6 (FLT)
/GND: BT1.2 (-), C1.1, C2.2, C3.2, C11.1, C12.2, C13.2, C14.1, C15.1, C16.2, C17.2, D1.2 (A), D2.1 (GND), D3.1 (GND), D5.1 (K), J1.A1 (GND), J1.A2 (TX1+), J1.A3 (TX1-), J1.A8 (SBU1), J1.A10 (RX2-), J1.A11 (RX2+), J1.A12 (GND), J1.B1 (GND), J1.B2 (TX2+), J1.B3 (TX2-), J1.B8 (SBU2), J1.B10 (RX1-), J1.B11 (RX1+), J1.B12 (GND), J1.S1 (SHIELD), J2.4, J3.2, J3.4, J3.6, J4.2, J4.3, J21.1, MH1.1, MH2.1, MH3.1, MH4.1, MH5.1, MH6.1, R2.2, R12.2, R14.2, R17.1, R21.1, SW1.1, U1.5 (ADDR), U1.10 (GND), U1.11 (EN_N), U2.16 (VSS), U2.32 (VSS), U2.33 (VSS), U3.2 (PGND), U3.9 (GND), U3.10 (PFM), U4.5 (NC), U4.6 (NC), U4.7 (NC), U4.8 (NC), U4.9 (NC), U4.10 (NC), U4.11 (NC), U4.12 (NC), U4.13 (GND), U5.2 (V-), U7.8 (GND), U7.9 (GND); also elsewhere on the board
/HV_EN: J7.1, R12.1, U2.8 (PA2), U7.2 (EN/UV); also elsewhere on the board
/HV_IN: C1.2, U7.5 (OUT); also elsewhere on the board
/HV_OUT: J3.1, J3.3, J3.5, J8.1, R20.1; also elsewhere on the board
/ILM: J6.1, R14.1, U2.6 (PA0), U7.7 (ILM)
/LED: R13.1, U2.3 (PC15/OSC)
/MCO: J5.1, U2.18 (PA8)
/NIXIE_EN: J4.5, U2.13 (PA7)
/NRST: J2.6, J18.1, SW1.2, U2.4 (NRST), U4.4 (nRST)
/RTC: R19.1, U2.28 (PB5), U4.3 (nINT)
/SCL: J4.4, J11.1, R5.1, U1.8 (SCL), U2.19 (PA9), U4.16 (SCL)
/SDA: J4.6, J12.1, R4.1, U1.7 (SDA), U2.20 (PA10), U4.15 (SDA)
/SWCLK: J2.1, U2.24 (PA14/SWCLK)
/SWDIO: J2.3, U2.23 (PA13/SWDIO)
/SWO: J2.5, J17.1, U2.26 (PB3/SWO)
/UART_RX: J20.1, U2.30 (PB7)
/UART_TX: J19.1, U2.29 (PB6)
/USB: R3.2, U1.6 (INT_N), U2.27 (PB4)
/USB_N: D3.3 (IO2), J1.A7 (D-), J1.B7 (D-), U2.21 (PA11)
/USB_P: D3.2 (IO1), J1.A6 (D+), J1.B6 (D+), U2.22 (PA12)
/VBUS: C2.1, C3.1, D1.1 (K), J1.A4 (VBUS), J1.A9 (VBUS), J1.B4 (VBUS), J1.B9 (VBUS), J16.1, R1.1, U3.4 (VIN), U3.5 (VIN), U3.6 (VIN), U3.7 (VINA), U3.8 (EN), U7.3 (IN), U7.4 (IN)
/VDD: C11.2, C12.1, C13.1, C14.2, C15.2, C16.1, J2.2, J14.1, R3.1, R4.2, R5.2, R15.1, R16.2, R18.1, R19.2, SW2.2, U1.12 (VDD), U2.1 (VDD), U2.5 (VDDA), U2.17 (VDD), U3.12 (VOUT), U3.13 (VOUT), U3.14 (VOUT), U4.2 (VCC), U5.6 (V+)
/VNIXIE: J4.1, J15.1, U5.1 (OUT), U5.4 (-IN)
unnamed: BT1.1 (+), U4.14 (VBAT)
unnamed: C17.1, U7.1 (dVdt)
unnamed: D5.2 (A), R13.2
unnamed: L1.1, U3.3 (L1)
unnamed: L1.2, U3.1 (L2)
unnamed: R1.2, U1.3 (VBUS)
unnamed: R2.1, SW2.1, U2.31 (PH3/BOOT0)
unnamed: R16.1, R17.2, U3.11 (FB)
unnamed: R20.2, R21.2, U2.7 (PA1)

Notes on the sheet:
ADDR: 0x47
ADDR: 0x70-0x73

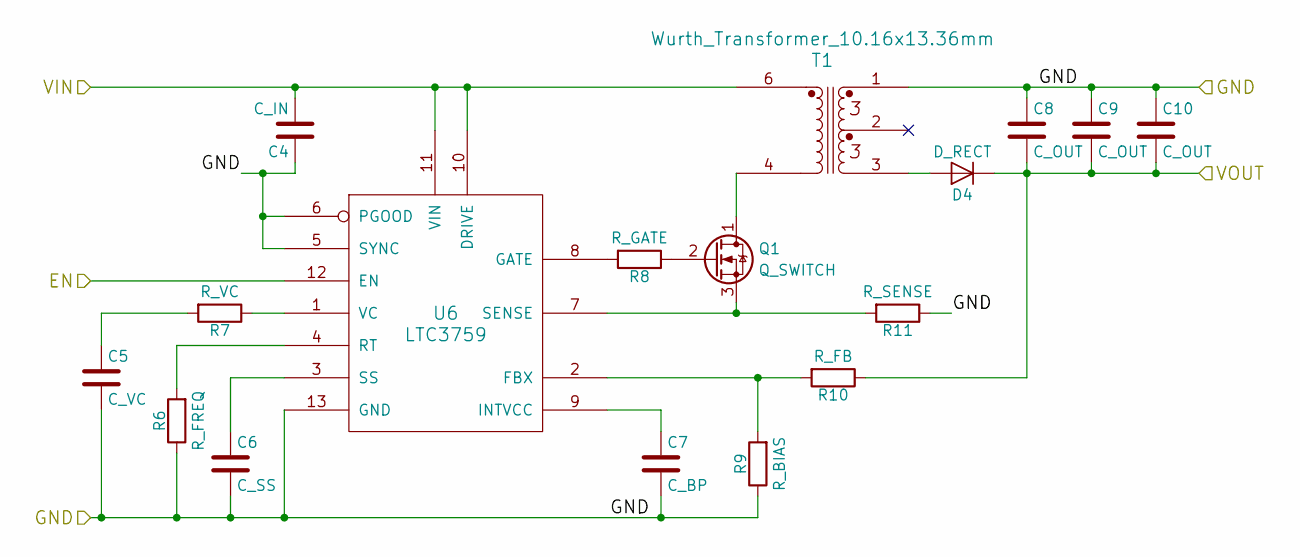
[picture p35: schematic hv_power_supply.sch, Bottom PCB]

Parts:
C4: C_IN; C_0805
C5: C_VC; C_0603
C6: C_SS; C_0603
C7: C_BP; C_0603
C8, C10: C_OUT; C_2220
C9: C_OUT; C_1812
D4: D_RECT; SOD-123W
Q1: Q_SWITCH; SOT-669_LFPAK
R6: R_FREQ; R_0603
R7: R_VC; R_0603
R8: R_GATE; R_0603
R9: R_BIAS; R_0603
R10: R_FB; R_0603
R11: R_SENSE; R_0805
T1: Wurth_Transformer_10.16x13.36mm; Wurth_WE-FB_10.18x13.36mm_Reverse
U6: LTC3759; MSOP-12-1EP_3x4mm_Pitch0.65mm

Connections:
/GND: C4.1, C5.2, C6.2, C7.2, C8.1, C9.1, C10.1, R6.1, R9.1, R11.1, T1.1, U6.5 (SYNC), U6.6 (PGOOD), U6.13 (GND); also elsewhere on the board
/HV_EN: U6.12 (EN); also elsewhere on the board
/HV_IN: C4.2, T1.6, U6.10 (DRIVE), U6.11 (VIN); also elsewhere on the board
/HV_OUT: C8.2, C9.2, C10.2, D4.1 (K), R10.1; also elsewhere on the board
unnamed: C5.1, R7.2
unnamed: C6.1, U6.3 (SS)
unnamed: C7.1, U6.9 (INTVCC)
unnamed: D4.2 (A), T1.3
unnamed: Q1.1 (D), T1.4
unnamed: Q1.2 (G), R8.1
unnamed: Q1.3 (S), R11.2, U6.7 (SENSE)
unnamed: R6.2, U6.4 (RT)
unnamed: R7.1, U6.1 (VC)
unnamed: R8.2, U6.8 (GATE)
unnamed: R9.2, R10.2, U6.2 (FBX)

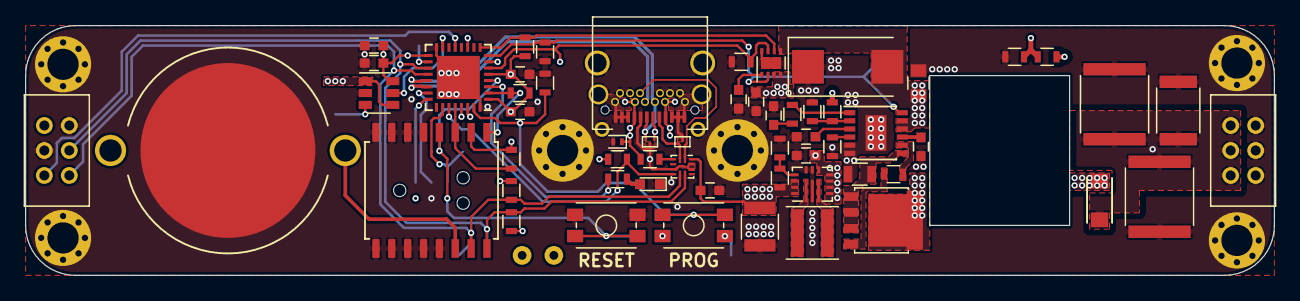
[picture p36: board nixie_bottom_board.kicad_pcb from above]

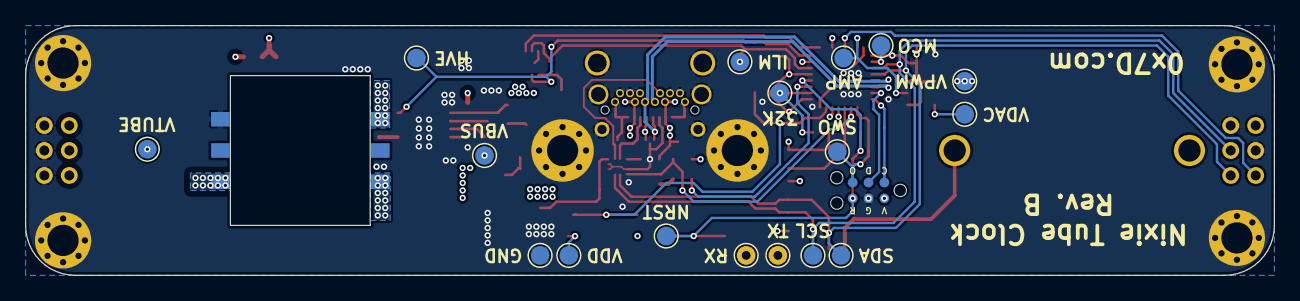
[picture p37: board nixie_bottom_board.kicad_pcb from below]

Board: 4 copper layers, 100.0 x 20.0 mm, 83 parts (18 on the bottom side), 49 nets.
