jacky4566/JacksNixies/Research/0x7d_nixietubeclock/Nixie_PSU_Breakout/nixie_psu_breakout.kicad_pcb

## KiCad design Research/0x7d_nixietubeclock/Nixie_PSU_Breakout/nixie_psu_breakout.kicad_pcb (2020-06-26)

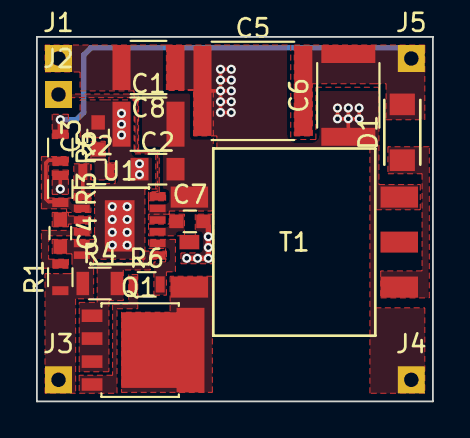
[picture p38: board nixie_psu_breakout.kicad_pcb from above]

Board: 2 copper layers, 22.0 x 20.2 mm, 23 parts (0 on the bottom side), 15 nets.

Parts:
C1, C8: C_IN; C_1210
C2: C_IN; C_0805
C3: C_VC; C_0603
C4: C_SS; C_0603
C5: C_OUT; C_2220
C6: C_OUT; C_1812
C7: C_BP; C_0603
D1: D_RECT; SOD-123W
J1: VIN; Measurement_Point_Square-TH_Small
J2: EN; Measurement_Point_Square-TH_Small
J3, J4: GND; Measurement_Point_Square-TH_Small
J5: VOUT; Measurement_Point_Square-TH_Small
Q1: Q_SWITCH; SOT-669_LFPAK
R1: R_FREQ; R_0603
R2: R_VC; R_0603
R3: R_BIAS; R_0603
R4: R_SENSE; R_0805
R5: R_FB; R_0603
R6: R_GATE; R_0603
T1: Wurth_Transformer_10.16x13.36mm; Wurth_WE-FB_10.18x13.36mm
U1: LTC3759; MSOP-12-1EP_3x4mm_Pitch0.65mm

Connections:
GNDREF: C1.1, C2.1, C3.2, C4.2, C5.1, C6.1, C7.2, C8.1, J3.1, J4.1, R1.1, R3.1, R4.1, T1.1, U1.5, U1.6, U1.13
unnamed: C1.2, C2.2, C8.2, J1.1, T1.6, U1.10, U1.11
unnamed: C3.1, R2.2
unnamed: C4.1, U1.3
unnamed: C5.2, C6.2, D1.1, J5.1, R5.1
unnamed: C7.1, U1.9
unnamed: D1.2, T1.3
unnamed: J2.1, U1.12
unnamed: Q1.1, T1.4
unnamed: Q1.2, R6.1
unnamed: Q1.3, R4.2, U1.7
unnamed: R1.2, U1.4
unnamed: R2.1, U1.1
unnamed: R3.2, R5.2, U1.2
unnamed: R6.2, U1.8
