jacky4566/JacksNixies/PCBV2/PCBV2.kicad_pcb

## KiCad design PCBV2/PCBV2.kicad_pcb (2020-06-26)

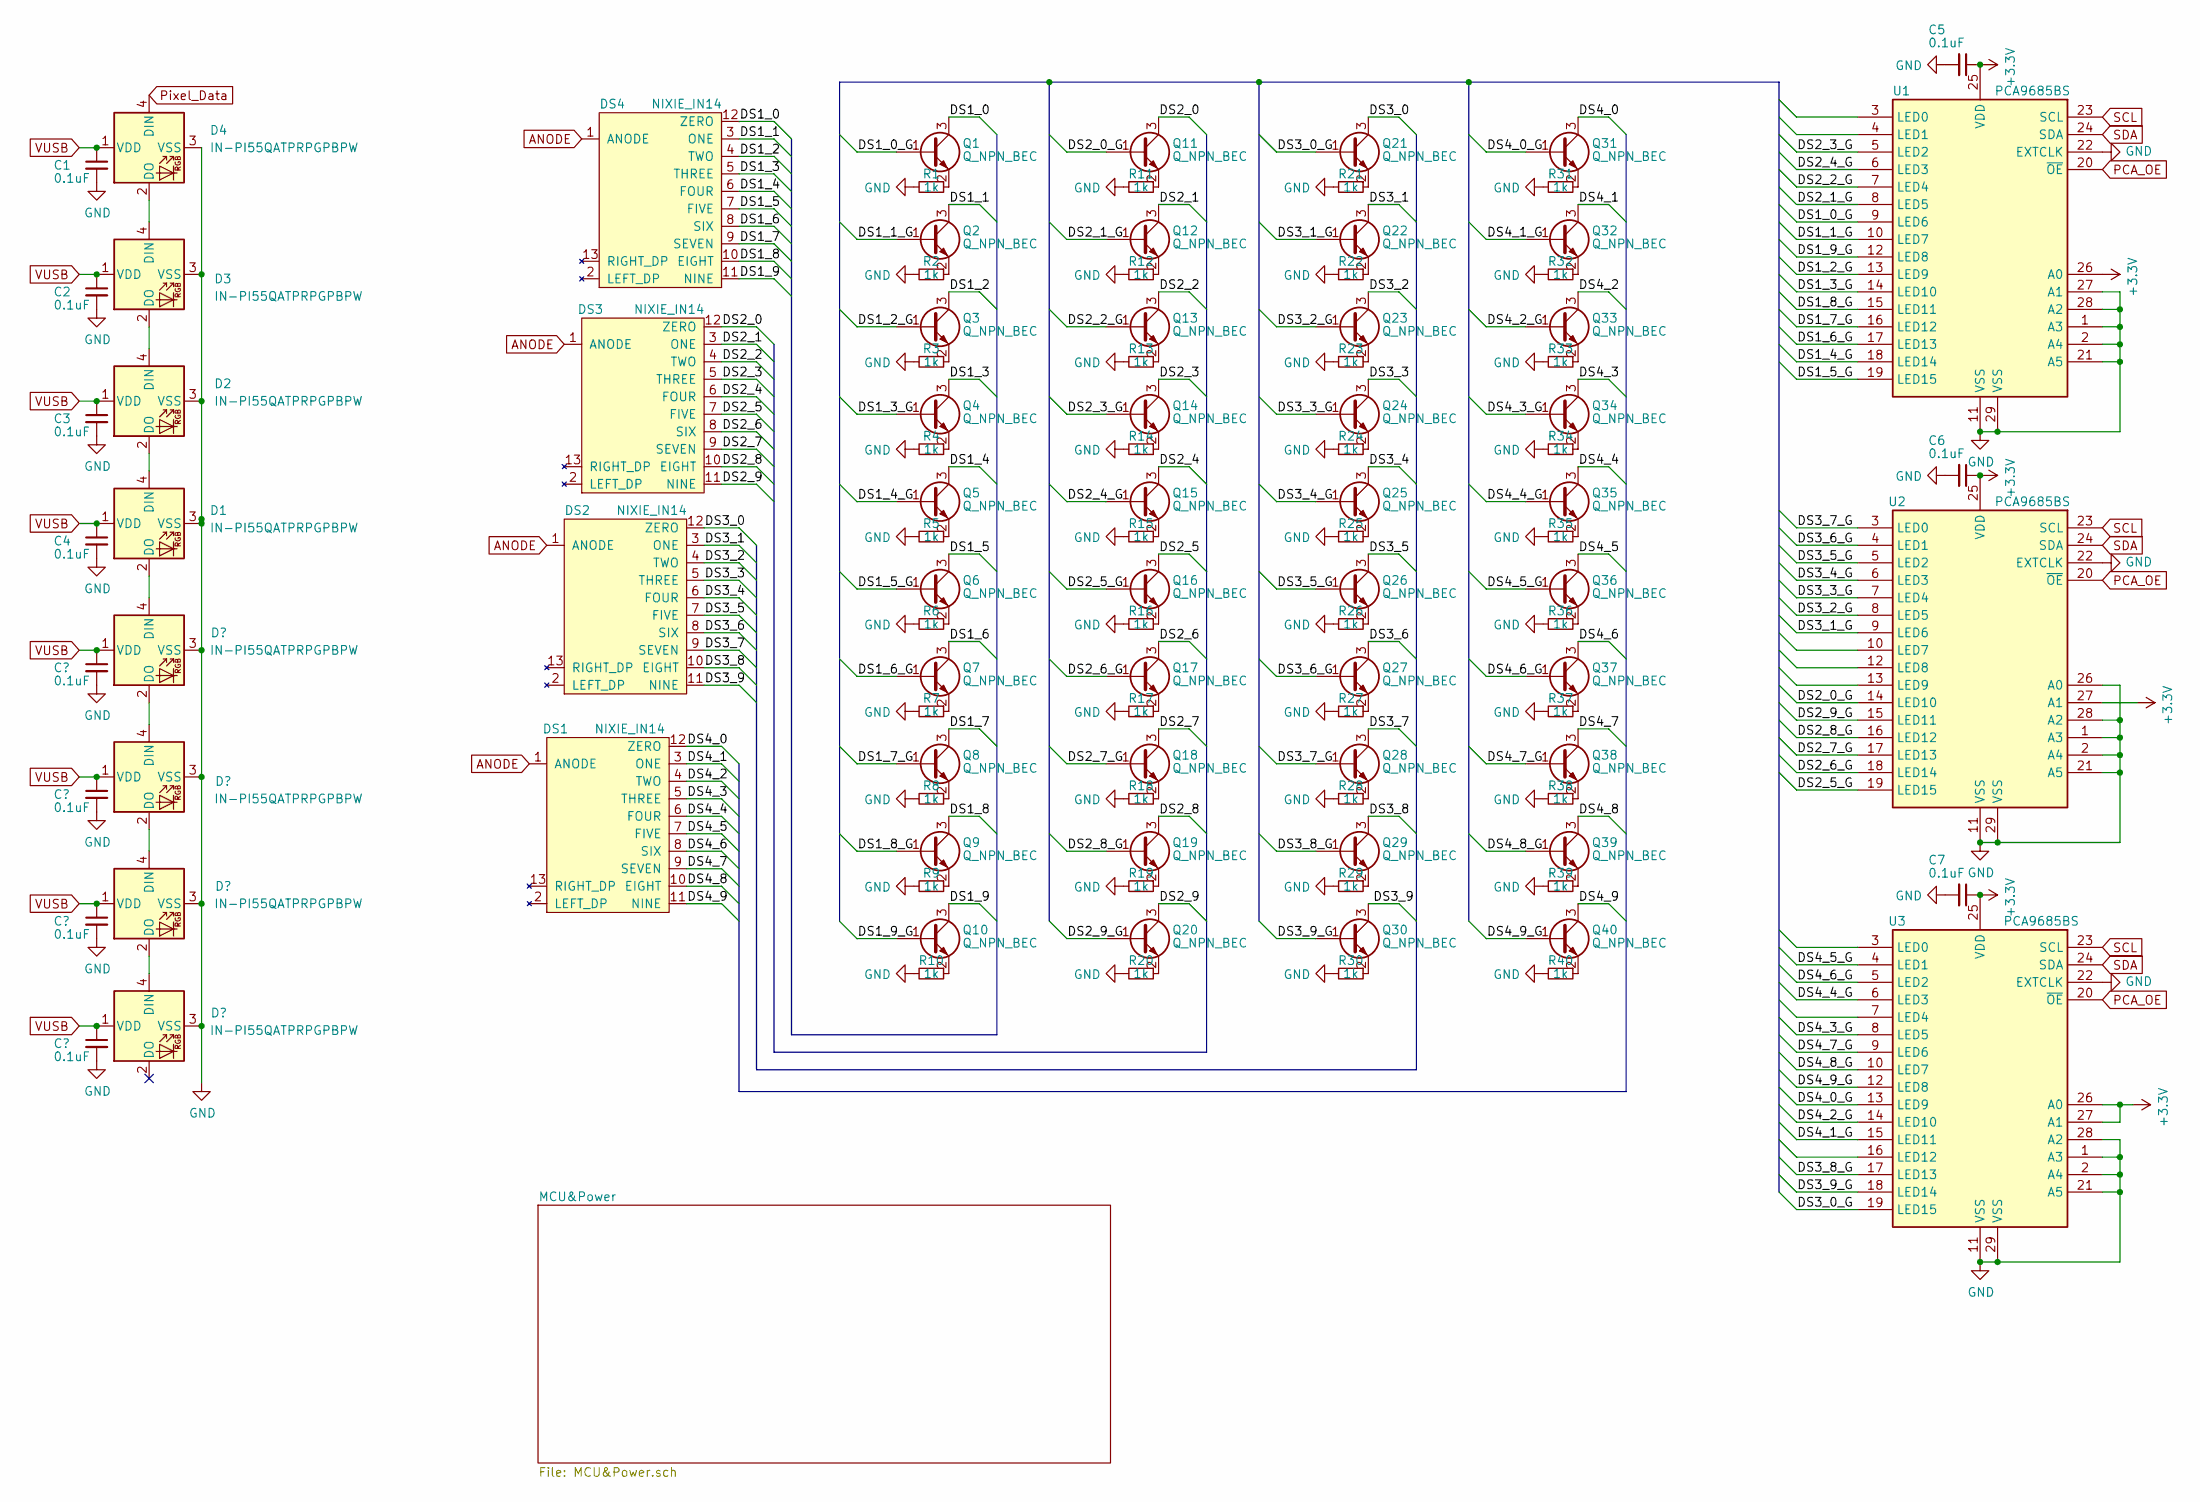
[picture p39: schematic PCBV2.sch]

Parts:
C1, C2, C3, C4, C5, C6, C7: 0.1uF; C_0603_1608Metric
D1, D2, D3, D4: IN-PI55QATPRPGPBPW; LED_Inolux_IN-PI554FCH_PLCC4_5.0x5.0mm_P3.2mm
DS1, DS2, DS3, DS4: NIXIE_IN14; Nixie_IN_14
Q1, Q2, Q3, Q4, Q5, Q6, Q7, Q8, Q9, Q10, Q11, Q12, Q13, Q14, Q15, Q16, Q17, Q18, Q19, Q20, Q21, Q22, Q23, Q24, Q25, Q26, Q27, Q28, Q29, Q30, Q31, Q32, Q33, Q34, Q35, Q36, Q37, Q38, Q39, Q40: Q_NPN_BEC; SOT-323; Manufacturer Part Number MSD42WT1G
R1, R2, R3, R4, R5, R6, R7, R8, R9, R10, R11, R12, R13, R14, R15, R16, R17, R18, R19, R20, R21, R22, R23, R24, R25, R26, R27, R28, R29, R30, R31, R32, R33, R34, R35, R36, R37, R38, R39, R40: 1k; R_0603_1608Metric
U1, U2, U3: PCA9685BS; QFN-28-1EP_6x6mm_P0.65mm_EP4.25x4.25mm_ThermalVias

Connections:
+3V3: C5.1, C6.1, C7.1, U1.25 (VDD), U1.26 (A0), U2.25 (VDD), U2.27 (A1), U3.25 (VDD), U3.26 (A0), U3.27 (A1); also elsewhere on the board
/DS1_0: DS4.12 (ZERO), Q1.3 (C)
/DS1_0_G: Q1.1 (B), U1.9 (LED6)
/DS1_1: DS4.3 (ONE), Q2.3 (C)
/DS1_1_G: Q2.1 (B), U1.10 (LED7)
/DS1_2: DS4.4 (TWO), Q3.3 (C)
/DS1_2_G: Q3.1 (B), U1.13 (LED9)
/DS1_3: DS4.5 (THREE), Q4.3 (C)
/DS1_3_G: Q4.1 (B), U1.14 (LED10)
/DS1_4: DS4.6 (FOUR), Q5.3 (C)
/DS1_4_G: Q5.1 (B), U1.18 (LED14)
/DS1_5: DS4.7 (FIVE), Q6.3 (C)
/DS1_5_G: Q6.1 (B), U1.19 (LED15)
/DS1_6: DS4.8 (SIX), Q7.3 (C)
/DS1_6_G: Q7.1 (B), U1.17 (LED13)
/DS1_7: DS4.9 (SEVEN), Q8.3 (C)
/DS1_7_G: Q8.1 (B), U1.16 (LED12)
/DS1_8: DS4.10 (EIGHT), Q9.3 (C)
/DS1_8_G: Q9.1 (B), U1.15 (LED11)
/DS1_9: DS4.11 (NINE), Q10.3 (C)
/DS1_9_G: Q10.1 (B), U1.12 (LED8)
/DS2_0: DS3.12 (ZERO), Q11.3 (C)
/DS2_0_G: Q11.1 (B), U2.14 (LED10)
/DS2_1: DS3.3 (ONE), Q12.3 (C)
/DS2_1_G: Q12.1 (B), U1.8 (LED5)
/DS2_2: DS3.4 (TWO), Q13.3 (C)
/DS2_2_G: Q13.1 (B), U1.7 (LED4)
/DS2_3: DS3.5 (THREE), Q14.3 (C)
/DS2_3_G: Q14.1 (B), U1.5 (LED2)
/DS2_4: DS3.6 (FOUR), Q15.3 (C)
/DS2_4_G: Q15.1 (B), U1.6 (LED3)
/DS2_5: DS3.7 (FIVE), Q16.3 (C)
/DS2_5_G: Q16.1 (B), U2.19 (LED15)
/DS2_6: DS3.8 (SIX), Q17.3 (C)
/DS2_6_G: Q17.1 (B), U2.18 (LED14)
/DS2_7: DS3.9 (SEVEN), Q18.3 (C)
/DS2_7_G: Q18.1 (B), U2.17 (LED13)
/DS2_8: DS3.10 (EIGHT), Q19.3 (C)
/DS2_8_G: Q19.1 (B), U2.16 (LED12)
/DS2_9: DS3.11 (NINE), Q20.3 (C)
/DS2_9_G: Q20.1 (B), U2.15 (LED11)
/DS3_0: DS2.12 (ZERO), Q21.3 (C)
/DS3_0_G: Q21.1 (B), U3.19 (LED15)
/DS3_1: DS2.3 (ONE), Q22.3 (C)
/DS3_1_G: Q22.1 (B), U2.9 (LED6)
/DS3_2: DS2.4 (TWO), Q23.3 (C)
/DS3_2_G: Q23.1 (B), U2.8 (LED5)
/DS3_3: DS2.5 (THREE), Q24.3 (C)
/DS3_3_G: Q24.1 (B), U2.7 (LED4)
/DS3_4: DS2.6 (FOUR), Q25.3 (C)
/DS3_4_G: Q25.1 (B), U2.6 (LED3)
/DS3_5: DS2.7 (FIVE), Q26.3 (C)
/DS3_5_G: Q26.1 (B), U2.5 (LED2)
/DS3_6: DS2.8 (SIX), Q27.3 (C)
/DS3_6_G: Q27.1 (B), U2.4 (LED1)
/DS3_7: DS2.9 (SEVEN), Q28.3 (C)
/DS3_7_G: Q28.1 (B), U2.3 (LED0)
/DS3_8: DS2.10 (EIGHT), Q29.3 (C)
/DS3_8_G: Q29.1 (B), U3.17 (LED13)
/DS3_9: DS2.11 (NINE), Q30.3 (C)
/DS3_9_G: Q30.1 (B), U3.18 (LED14)
/DS4_0: DS1.12 (ZERO), Q31.3 (C)
/DS4_0_G: Q31.1 (B), U3.13 (LED9)
/DS4_1: DS1.3 (ONE), Q32.3 (C)
/DS4_1_G: Q32.1 (B), U3.15 (LED11)
/DS4_2: DS1.4 (TWO), Q33.3 (C)
/DS4_2_G: Q33.1 (B), U3.14 (LED10)
/DS4_3: DS1.5 (THREE), Q34.3 (C)
/DS4_3_G: Q34.1 (B), U3.8 (LED5)
/DS4_4: DS1.6 (FOUR), Q35.3 (C)
/DS4_4_G: Q35.1 (B), U3.6 (LED3)
/DS4_5: DS1.7 (FIVE), Q36.3 (C)
/DS4_5_G: Q36.1 (B), U3.4 (LED1)
/DS4_6: DS1.8 (SIX), Q37.3 (C)
/DS4_6_G: Q37.1 (B), U3.5 (LED2)
/DS4_7: DS1.9 (SEVEN), Q38.3 (C)
/DS4_7_G: Q38.1 (B), U3.9 (LED6)
/DS4_8: DS1.10 (EIGHT), Q39.3 (C)
/DS4_8_G: Q39.1 (B), U3.10 (LED7)
/DS4_9: DS1.11 (NINE), Q40.3 (C)
/DS4_9_G: Q40.1 (B), U3.12 (LED8)
ANODE: DS1.1 (ANODE), DS2.1 (ANODE), DS3.1 (ANODE), DS4.1 (ANODE); also elsewhere on the board
GND: C1.2, C2.2, C3.2, C4.2, C5.2, C6.2, C7.2, D1.3 (VSS), D2.3 (VSS), D3.3 (VSS), D4.3 (VSS), R1.2, R2.2, R3.2, R4.2, R5.2, R6.2, R7.2, R8.2, R9.2, R10.2, R11.2, R12.2, R13.2, R14.2, R15.2, R16.2, R17.2, R18.2, R19.2, R20.2, R21.2, R22.2, R23.2, R24.2, R25.2, R26.2, R27.2, R28.2, R29.2, R30.2, R31.2, R32.2, R33.2, R34.2, R35.2, R36.2, R37.2, R38.2, R39.2, R40.2, U1.1 (A3), U1.2 (A4), U1.11 (VSS), U1.21 (A5), U1.22 (EXTCLK), U1.27 (A1), U1.28 (A2), U1.29 (VSS), U2.1 (A3), U2.2 (A4), U2.11 (VSS), U2.21 (A5), U2.22 (EXTCLK), U2.26 (A0), U2.28 (A2), U2.29 (VSS), U3.1 (A3), U3.2 (A4), U3.11 (VSS), U3.21 (A5), U3.22 (EXTCLK), U3.28 (A2), U3.29 (VSS); also elsewhere on the board
unnamed: D1.4 (DIN), D2.2 (DO)
unnamed: D2.4 (DIN), D3.2 (DO)
unnamed: D3.4 (DIN), D4.2 (DO)
unnamed: Q1.2 (E), R1.1
unnamed: Q2.2 (E), R2.1
unnamed: Q3.2 (E), R3.1
unnamed: Q4.2 (E), R4.1
unnamed: Q5.2 (E), R5.1
unnamed: Q6.2 (E), R6.1
unnamed: Q7.2 (E), R7.1
unnamed: Q8.2 (E), R8.1
unnamed: Q9.2 (E), R9.1
unnamed: Q10.2 (E), R10.1
unnamed: Q11.2 (E), R11.1
unnamed: Q12.2 (E), R12.1
unnamed: Q13.2 (E), R13.1
unnamed: Q14.2 (E), R14.1
unnamed: Q15.2 (E), R15.1
unnamed: Q16.2 (E), R16.1
unnamed: Q17.2 (E), R17.1
unnamed: Q18.2 (E), R18.1
unnamed: Q19.2 (E), R19.1
unnamed: Q20.2 (E), R20.1
unnamed: Q21.2 (E), R21.1
unnamed: Q22.2 (E), R22.1
unnamed: Q23.2 (E), R23.1
unnamed: Q24.2 (E), R24.1
unnamed: Q25.2 (E), R25.1
unnamed: Q26.2 (E), R26.1
unnamed: Q27.2 (E), R27.1
unnamed: Q28.2 (E), R28.1
unnamed: Q29.2 (E), R29.1
unnamed: Q30.2 (E), R30.1
unnamed: Q31.2 (E), R31.1
unnamed: Q32.2 (E), R32.1
unnamed: Q33.2 (E), R33.1
unnamed: Q34.2 (E), R34.1
unnamed: Q35.2 (E), R35.1
unnamed: Q36.2 (E), R36.1
unnamed: Q37.2 (E), R37.1
unnamed: Q38.2 (E), R38.1
unnamed: Q39.2 (E), R39.1
unnamed: Q40.2 (E), R40.1
PCA_OE: U1.20 (~OE), U2.20 (~OE), U3.20 (~OE); also elsewhere on the board
Pixel_Data: D4.4 (DIN); also elsewhere on the board
SCL: U1.23 (SCL), U2.23 (SCL), U3.23 (SCL); also elsewhere on the board
SDA: U1.24 (SDA), U2.24 (SDA), U3.24 (SDA); also elsewhere on the board
VUSB: C1.1, C2.1, C3.1, C4.1, D1.1 (VDD), D2.1 (VDD), D3.1 (VDD), D4.1 (VDD); also elsewhere on the board

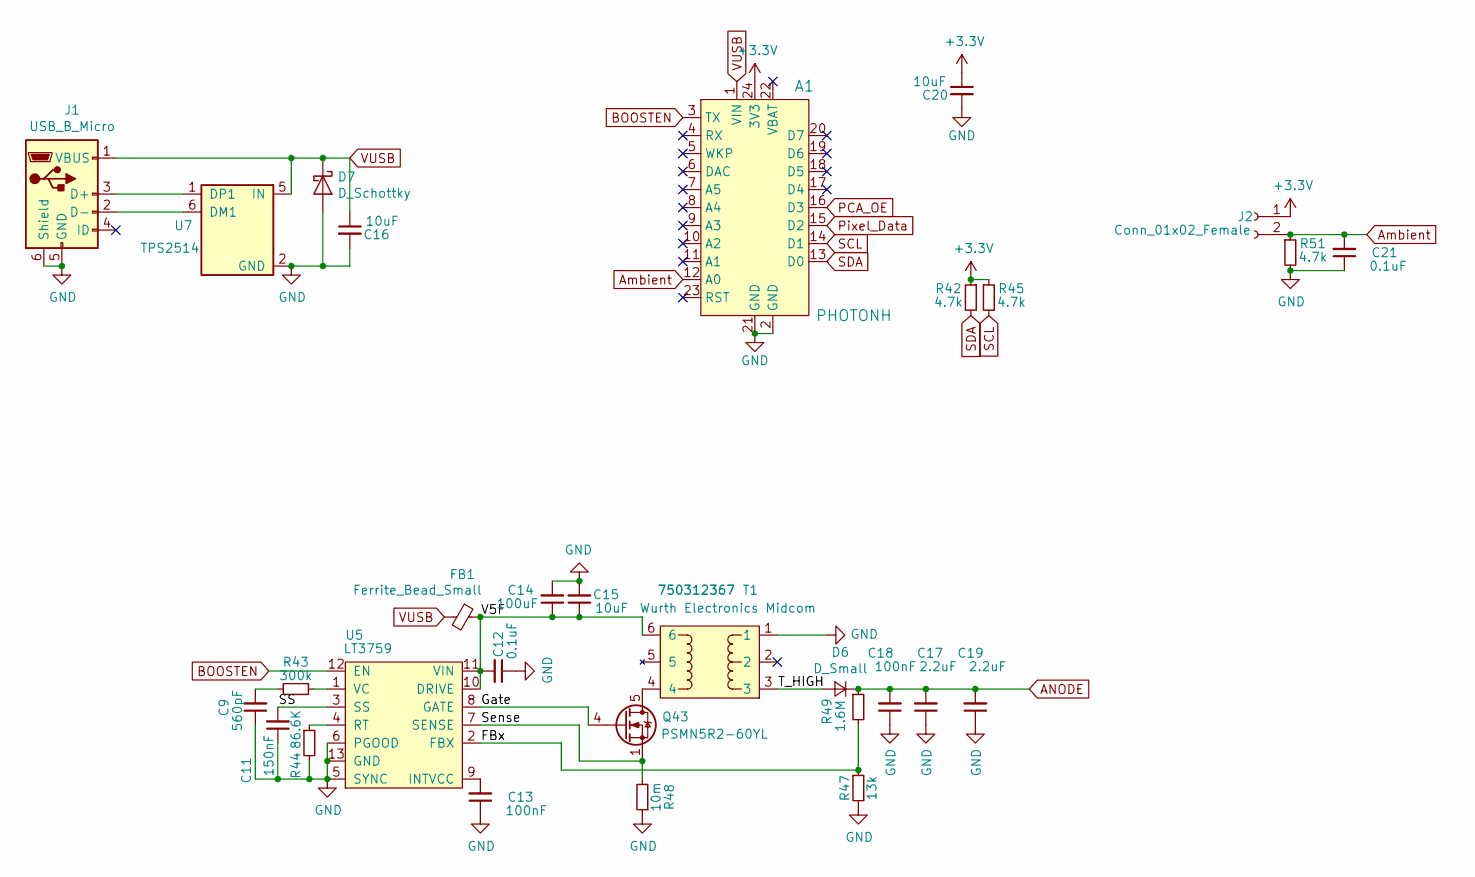
[picture p40: schematic MCU&Power.sch]

Parts:
A1: PHOTONH; Particle_Photon; MPN PHOTONH; Digi-Key_PN 1878-1000-ND
C9: 560pF; C_0603_1608Metric
C11: 150nF; C_0603_1608Metric
C12, C21: 0.1uF; C_0603_1608Metric
C13: 100nF; C_0603_1608Metric
C14: 100uF; C_1206_3216Metric
C15, C16, C20: 10uF; C_0805_2012Metric
C17, C19: 2.2uF; C_2220_5650Metric
C18: 100nF; C_1210_3225Metric
D6: D_Small; D_SOD-123; Part UF1GLWHRVGCT-ND
D7: D_Schottky; D_SOD-123
FB1: Ferrite_Bead_Small; R_0805_2012Metric
J1: USB_B_Micro; USB_Micro-B_GCT_USB3076-30-A
J2: Conn_01x02_Female; PinHeader_1x02_P2.54mm_Vertical
Q43: PSMN5R2-60YL; LFPAK56
R42, R45, R51: 4.7k; R_0603_1608Metric
R43: 300k; R_0603_1608Metric
R44: 86.6K; R_0603_1608Metric
R47: 13k; R_0603_1608Metric
R48: 10m; R_1206_3216Metric
R49: 1.6M; R_0603_1608Metric
T1: 750312367; Manufacturer Part Number 750312367
U5: LT3759; MSOP-12-1EP_3x4mm_P0.65mm_EP1.65x2.85mm_ThermalVias
U7: TPS2514; SOT-23-6

Connections:
+3V3: A1.24 (3V3), C20.1, J2.1, R42.1, R45.1; also elsewhere on the board
/MCU&Power/FBx: R47.1, R49.2, U5.2 (FBX)
/MCU&Power/Gate: Q43.4 (G), U5.8 (GATE)
/MCU&Power/SPI_CLK: A1.9 (A3); also elsewhere on the board
/MCU&Power/SPI_CS: A1.10 (A2); also elsewhere on the board
/MCU&Power/SPI_MISO: A1.8 (A4); also elsewhere on the board
/MCU&Power/SPI_MOSI: A1.7 (A5); also elsewhere on the board
/MCU&Power/SS: C11.2, U5.3 (SS)
/MCU&Power/Sense: Q43.1 (S), Q43.2 (S), Q43.3 (S), R48.2, U5.7 (SENSE)
/MCU&Power/T_HIGH: D6.2 (A), T1.3
/MCU&Power/V5F: C12.2, C14.1, C15.1, FB1.1, T1.6, U5.10 (DRIVE), U5.11 (VIN)
ANODE: C17.2, C18.2, C19.2, D6.1 (K), R49.1; also elsewhere on the board
Ambient: A1.12 (A0), C21.2, J2.2, R51.1
BOOSTEN: A1.3 (TX), U5.12 (EN)
GND: A1.2 (GND), A1.21 (GND), C9.1, C11.1, C12.1, C13.1, C14.2, C15.2, C16.2, C17.1, C18.1, C19.1, C20.2, C21.1, D7.2 (A), J1.5 (GND), J1.6 (Shield), R44.2, R47.2, R48.1, R51.2, T1.1, U5.5 (SYNC), U5.6 (PGOOD), U5.13 (GND), U7.2 (GND); also elsewhere on the board
MOTION: A1.17 (D4); also elsewhere on the board
unnamed: C9.2, R43.2
unnamed: C13.2, U5.9 (INTVCC)
unnamed: J1.2 (D-), U7.6 (DM1)
unnamed: J1.3 (D+), U7.1 (DP1)
unnamed: Q43.5 (D), T1.4
unnamed: R43.1, U5.1 (VC)
unnamed: R44.1, U5.4 (RT)
PCA_OE: A1.16 (D3); also elsewhere on the board
Pixel_Data: A1.15 (D2); also elsewhere on the board
SCL: A1.14 (D1), R45.2; also elsewhere on the board
SDA: A1.13 (D0), R42.2; also elsewhere on the board
SenseHigh: A1.20 (D7); also elsewhere on the board
VUSB: A1.1 (VIN), C16.1, D7.1 (K), FB1.2, J1.1 (VBUS), U7.5 (IN); also elsewhere on the board

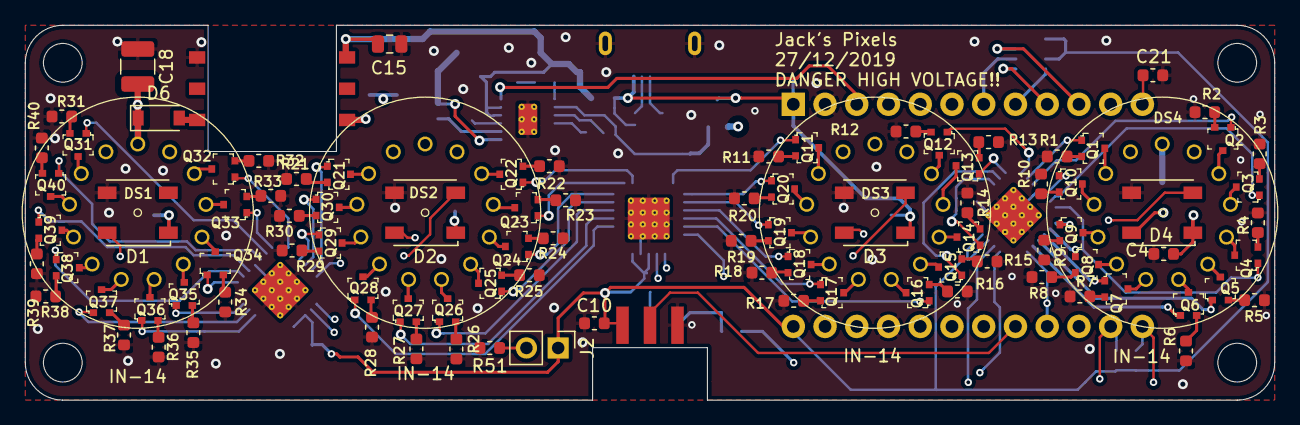
[picture p41: board PCBV2.kicad_pcb from above]

Board: 4 copper layers, 100.0 x 30.0 mm, 135 parts (0 on the bottom side), 154 nets.

Other parts of the board:
C8, C10: 0.1uF; C_0603_1608Metric
R41, R50: 1M; R_0603_1608Metric
R46: 86.6k; R_0603_1608Metric
U6: BME680; Bosch_LGA-8_3x3mm_P0.8mm_ClockwisePinNumbering
U8: AM612; AM612_Horz

Their connections:
+3V3: C8.1, C10.2, R50.2, U6.6, U6.8, U8.4; also elsewhere on the board
/MCU&Power/SPI_CLK: U6.4; also elsewhere on the board
/MCU&Power/SPI_CS: U6.2; also elsewhere on the board
/MCU&Power/SPI_MISO: U6.5; also elsewhere on the board
/MCU&Power/SPI_MOSI: U6.3; also elsewhere on the board
GND: C8.2, C10.1, R46.2, U6.1, U6.7, U8.3, U8.6; also elsewhere on the board
MOTION: U8.5; also elsewhere on the board
unnamed: R41.2, R46.1, U8.1
unnamed: R50.1, U8.2
SenseHigh: R41.1; also elsewhere on the board
