jacky4566/JacksNixies/Research/0x7d_nixietubeclock/Nixie_Firmware_Mbed/animation.h

#ifndef _ANIMATION_H_
#define _ANIMATION_H_

void Animate_Cycle_Basic(int iterations);
void Animate_Cycle_Analog(int iterations);
void Animate_Cycle_Low_Pwm(int iterations);
void Animate_Cycle_Pwm(int iterations);
void Animate_Cycle_Fade(int iterations);
void Animate_Cycle_Fade_Random(int iterations);
void Animate_Cycle_Fast(int iterations);
void Animate_Cycle_Fast_Random(int iterations);

#endif
